pthomas/ttsky-sigma-delta/STATUS.md

# Project status & session handoff

DESIGN.md is the append-only **decision log** (restructured 2026-07-26:
goals live in README.md, architecture/method/measured specs in docs/ —
the CI-generated manual — and toolchain + drive instructions here); this
file holds *where things stand and how to drive them*. Update both at the
end of significant work sessions.

**Trust note:** two magic gotchas have burned this project's DRC numbers in
both directions (see DESIGN.md 2026-07-19 decision log entries): (1) fresh
`load` without `select top cell; expand` silently skips hierarchy-crossing
checks (false clean); (2) `writeall force` after `load` rewrites unmodified
gencell subcells with halved coordinates, manufacturing hundreds of fake
sub-0.005um violations on the *next* load (false dirty — the entire "894
remaining" saga was this artifact). The only trustworthy number is a fresh
process on the saved files with expand; route_ota.py now prints exactly
that ("DRC errors (fresh reload of saved files)").

## Snapshot 2026-07-26 (current — read this first)

**The chip is submission-ready and materially better than the 07-25
morning version.** Full story in DESIGN.md (all dated 07-25/07-26);
one-paragraph version: the 0–3.3 V input range landed (RIN 132k +
ROFF 158.4k offset leg, thin-poly); the extracted-vs-tier-1 SNDR gap
was decomposed by a netlist-ladder A/B and turned out to be (a) slow
clk33 rise — fixed by lvl W_BP=20 + mid-row buffers — and (b) a
half-cycle excess loop delay from the StrongARM sensing on its
clock's FALL — fixed by clocking the comparator on clkb33 and driving
the DAC switches from its SR latch (DFF now retimes outputs only).
Extracted fast-path SNDR: **38.3–40.7 dB** (above the tier-1 band
36.4–38.0), corners ss 33.4 / ff 35.3. Acceptance re-instrumented:
2048-bit window, gate 36 (512-bit windows scatter ±3 dB). Analog
pins: **back to 2 (VIN + INT)** — the 07-26-morning VOFF +
vcm/vrefp-monitor pins were removed the same day on cost
(100 €/pin after the first two; 380 → 80 €); references are
validated through transfer-function inference instead (docs/09b
Phase 1), and the commercial window-slide experiment moves to v2.
Rebuilt + re-verified: sd_top DRC 0 / LVS match, extracted 40.2 dB,
frame DRC 0.

| Area | State |
|---|---|
| Nightly CI | scheduled 03:00 MT (GitLab schedule 4359193): assembly-verify (full from-source top regression) + top-corners. top-corners first regenerates the PEX and diffs it against the committed golden `spice/sd_top_pex.spice` (see DESIGN.md 2026-08-01) — a diff there means the deck drifted (layout/magic/PDK): review it, rerun the corner suite, update gates (measured − 2 dB to nearest 0.5), recommit the netlist. Never retry. Gates: ss 32 / ff 36.5 / v3.0 36 / v3.6 32.5 / 0C 33 / 85C 35. |
| Site | 14 chapters incl. datasheet (CI-injected electrical tables) and silicon test plan (docs/09b, 4 phases, measured-vs-CI correlation table is the deliverable) |
| Commercial | **local-only branch `commercial`** (never push; no upstream set). COMMERCIAL.md: thesis, cost model, decisions (power-conversion socket, differential required → v2 = fully-differential + 2nd-order in ONE architecture pass), open questions for Paul (channels, funding, license, name, PGA) |
| Fabric RTL | **suite green** (5/5, CI rtl-verify + locally via ~/.venv + iverilog): sdm_rx.v (AXI4-Lite + dual sinc³), cocotb TB incl. both mixed-signal tests (committed PEX bitstream → RTL → registers); pex_bits.txt refreshed from the 2-pin chip's 40.2 dB acceptance run. rtl/PLAN.md review still open |
| Bench plan | PolarFire SoC bench board (TT demo board hosts the chip; header adapter TBD); DAC = AD5541A (kernel ad5446 driver; MikroE DAC 8 Click or Pmod DA3 module, or bare on the adapter) |
| Open (user-side) | **re-submit/update the TT shuttle entry (frame fix 2026-07-26: 22 floating outputs now tied — submitted GDS predates it)**; Pages visibility toggle; rtl/PLAN.md review |

**Next actions (fresh context starts here):** (1) Paul reviews
rtl/PLAN.md → iterate; (2) install sim tools → first cocotb run of
rtl/tb (expect small RTL/TB fixes — never run yet); (3) module 2
sdm_cap (raw-bit capture, needed for Phase-2 silicon SNDR); (4)
commercial-branch paper items (k-tolerance sweep has existing tier-1
machinery). Reminder: `git push` on main pushes BOTH remotes; the
commercial branch must never gain an upstream.

## Where we are

**Shuttle: TTSKY26c (sky130A), deadline 2026-09-07.** Repo pushed to
git@gitlab.com:pthomas1/sigma-delta.git. Shuttle entry:
https://app.tinytapeout.com/projects/5413 (integration PR:
TinyTapeout/tinytapeout-sky-26c#143).

| Area | State |
|---|---|
| Tier 0 (python model) | done — sim/tier0.py; pattern-noise statistics understood |
| Tier 1 (behavioral xschem/ngspice) | done — full modulator with realistic OTA model (AOL/GBW/SR), RZ totem-pole DAC, interactive scope workflow |
| NRZ-vs-RZ decision | done — RZ confirmed by data (reports/dac_compare.html) |
| Block spec table | done — measured knees in DESIGN.md (AOL≥300, GBW≥50M, SR≥100V/µs) |
| Tier 2 OTA schematic | done — folded cascode sized & corner-flat (A0 65dB, GBW 209MHz, PM 58°, ±195V/µs, 4.5mW); xschem/ota.sch GENERATED from sim/ota_tb.py SIZES; equivalence proven (make xcheck) |
| Tier 2 other blocks | **StrongARM comparator DONE** (PMOS input; inverter-buffered NAND SR latch after a real hysteresis bug — see DESIGN.md; tau 77 ps tt / 63–97 ps corners, worst decision 1.18 ns, 71 µW, offset σ 13.6 mV MC N=19; schematic generated + equivalence proven via make compcheck). **DFF retimer DONE** (master-slave TG, verified in-chain behind the real comparator: clk-to-Q 0.37 ns, zero mid-cycle transitions). **Bias generator DONE** (sim/bias_tb.py: constant-gm + cascoded mirrors + startup-disable; OTA acceptance A0 65.4/GBW 194M/PM 57° with real bias, corners tighter than ideal — see DESIGN.md; open: sch gen + layout, poly R). **Reference buffers DONE** (sim/buf_tb.py: 3× 5T unity followers, Zout 754Ω vs ≤1k spec = 10× under breakage, bit-dep residuals ≤6.9mV, 3.2mW, corners flat — see DESIGN.md; open: sch gen, bias tap, layout+decap). **Clock level shifter DONE** (sim/lvl_tb.py: cross-coupled 1.8→3.3V, full swing, <1ns, duty ≤2.42% vs 3% gate — static duty = benign gain shift; ~300µW; corners × VDPWR sweep). **Output drivers DONE** (sim/odrv_tb.py: 5V-gate stage on the 1.8V rail — no thin-oxide overstress — + thin-oxide buffers; full swing, ≤0.4ns, Q/QB skew ≤407ps, ~180µW; corners × VDPWR). Demux REJECTED, no differential, no true LVDS (see DESIGN.md IO decisions). **ALL BLOCKS DESIGNED — next: top-level assembly** |
| Tier 3 layout cells | done — mag/rin, rdac, cint, sw_nmos (extraction-verified values) |
| Tier 3 OTA layout | **DRC CLEAN + LVS CLEAN + PEX done** (fresh-process verified, fast & full DRC styles; make lvs: "Circuits match uniquely", 13/13 devices, 15/15 nets). Extracted (0.72 pF parasitics): A0 65.2 dB / GBW 119 MHz / PM 46° / SR +128/-508 V/µs / Ivdd 1.37 mA — all tier-1 knees (A0≥49.5 dB, GBW≥50 MHz, SR≥100 V/µs) still met ≥2×; PM 46° (was 58° pre-PEX) is the open question — see below |
| Tier 1 params | params.py: fs=50MHz, CINT=2pF; **refs at 0.4/0.9/1.4V (open item 6 done 2026-07-19)** — tier-1 39.1/66.6 dB at the new window; comp_beh output now pinned to the digital mid-rail (domain-split bug, see DESIGN.md) |
| CI | 4 sim jobs (smoke/reports) + new **layout-verify** job (xcheck → ota_tb → pex → layout_report; fails on DRC≠0 or LVS mismatch) + **pages** job publishing the generated design doc. Runner VM rebuilt with source-built magic/netgen — layout-verify green. New **comparator** job (comp_tb --quick + compcheck + dff_tb + figures) |
| Pages site | `make site` → public/index.html: 10-chapter narrative (docs/*.md) with CI-injected numbers via tools/gen_docs.py, interactive three.js 3D stack-up of the OTA GDS, verdict chips, GDS download. Set Pages visibility to "everyone" in GitLab project settings for the public showcase |

## OTA layout DRC — resolved (2026-07-19)

**DRC 0, LVS clean.** The "894 remaining" from the mid-cleanup snapshot
(and both of its root-cause hypotheses — strap `ty ± 1.5um` landing in the
finger structure, bulk-tap guard-ring geometry) turned out to be wrong: all
894 were fake, manufactured by magic's `writeall force` halving the
coordinates of unmodified gencell subcell files on save (grid-quantization
of odd 0.005um coordinates; full mechanism + proof in DESIGN.md 2026-07-19
entry). The violation slivers sat between *device-internal* shapes (poly
contact row vs S/D diffusion top), which no strap-height change could ever
have fixed. The met1/met2/met3 via-enclosure violations (~4140) were real
and remain fixed via the `ENCLOSING_LAYERS`/`PAD` auto-padding in
route_ota.py. route_ota.py now writes only the parent cell (`save
ota_layout`) and self-verifies DRC via a fresh magic process on the saved
files — expect "DRC errors (fresh reload of saved files): 0".

## OTA post-PEX numbers (2026-07-19)

`make pex` = tools/pex_ota.py (magic C-only extraction, cthresh 0, no R)
-> spice/ota_pex.spice, then sim/ota_tb.py --pex (same 3-DUT deck, layout
netlist wrapped to the 5-pin interface with ideal refs).

| Metric | Schematic | Extracted | Tier-1 knee | Verdict |
|---|---|---|---|---|
| A0 | 65.2 dB | 65.2 dB | ≥49.5 dB | ok |
| GBW | 209 MHz | 119 MHz | ≥50 MHz | ok (2.4×) |
| PM | 58° | 46° | no knee down to 28° | ok — **closed 2026-07-19** |
| SR | +197/−253 | +128/−508 | ≥100 V/µs | ok |
| Ivdd | 1.37 mA | 1.37 mA | — | 4.5 mW |

The GBW/PM hit is self-load from the auto-router's generous metal (0.50 µm
via pads, 0.8 µm-pitch m1 track bus, m3 risers): 0.72 pF total parasitic on
top of CL=1.5 pF. **Resolved 2026-07-19:** the FP2 sweep in `make specs`
measured no SNDR knee down to PM 28° (see DESIGN.md decision log) — 46°
extracted is accepted, OTA layout closed for v1. Note the tier-1 deck now
runs gear integration and the precision baseline reads 64.8 dB (the old
77.8 was a lucky deterministic window; long-run truth is ~66).

## Toolchain (dev machine)

- ngspice 42, xschem 3.4.4 (apt) — fine.
- magic **8.3.676 source-built** (`/usr/local/bin/magic`) — noble's 8.3.105 is
  too old for the PDK. Runner VM source-builds the same version (cloud-init).
- netgen **1.5.323 source-built** at /usr/local/bin (apt mesher removed).
- PDK: sky130A via ciel at `PDK_ROOT=/home/nvme/pdk` (pinned hash in
  ci/lxd/cloud-init.yml and DESIGN.md); `/opt/pdk` on the runner.
- glab installed but **no token stored** — `glab auth login` with api scope
  would enable pipeline debugging from the session.
- **magic batch DRC gotcha** (see DESIGN.md 2026-07-19 entry): always
  `select top cell; expand` before `drc check`/`drc listall ...` on anything
  loaded from a saved .mag file, or hierarchy-crossing violations are
  silently skipped and you'll see a false "0 errors".

## How to drive everything

From repo root (xschemrc auto-loads; PDK_ROOT defaults to /home/nvme/pdk):

- `make` / `make snr` — tier-1 sim + SNDR table (~10 s)
- `make framecheck` — TT requirements precheck misses: frame connectivity, tied outputs, info.yaml consistency, no met5 (after `make tt`)
- `make antenna` — magic antennacheck on sd_top (sky130A gets NO antenna check from TT precheck)
- `make jitter` — tier-0 clock-jitter susceptibility sweep (~30 s)
- `make noise` — OTA 1/f + thermal noise budget, `sim/noise_tb.py --pex` for extracted (~5 s)
- `make report` — NRZ/RZ comparison → reports/dac_compare.html (~70 s)
- `make char` — device curves → reports/fet_char.html (~15 s)
- `make specs` — OTA requirement sweeps → reports/ota_specs.html (~6 min)
- `python3 sim/ota_tb.py` — OTA testbench (edit SIZES dict to resize)
- `make xcheck` — regenerate xschem/ota.sch from SIZES + prove equivalence
- `make layout` — regenerate the four passive/switch cells in magic
- `make lvs` — netgen LVS, mag/ota_layout.spice vs spice/ota_top.spice
- `python3 tools/gen_ota_layout.py && python3 tools/route_ota.py` — regenerate
  + route the OTA layout, extraction-compare vs golden (expect 13/13); the
  trustworthy DRC number is the "fresh reload of saved files" line (expect 0)
- `make pex` — parasitic-extract the routed layout + run the OTA TB on it
- `make layout-report` — fresh-process DRC + LVS + GDS export + 3D geometry
  (fails if DRC ≠ 0 or LVS mismatch; feeds the site)
- `make site` — build public/ from docs/*.md + reports/results/*.json
  (preview: `cd public && python3 -m http.server`)
- GUI schematic: `xschem xschem/tier1_sdm.sch` → Netlist → Simulate (silent
  ~10 s) → Ctrl-click LOAD WAVES; f=fit, right-drag=zoom, a/b=cursors
- GUI layout: `magic -rcfile $PDK_ROOT/sky130A/libs.tech/magic/sky130A.magicrc mag/ota_layout.mag`

## Next actions — ASSEMBLY CAMPAIGN (all blocks -> layout -> TT frame)

User directive (2026-07-19): "do all the things" — lay out every block,
assemble the top level into the TT frame, per-component report sub-pages,
report when TT-ready. Commit per milestone. Ordered plan with the key
context a fresh session needs:

1. **Reference plan fix — DONE 2026-07-19.** CDEC = 5 pF per reference
   (tier-1 validated at RREF=754, CDEC 20/10/5/2 pF all inside scatter;
   ~7.5k um^2 total MiM, fits). Ladder added: 190k/50k/50k/40k off VAPWR
   (~10 uA) feeding the buffer gates, now in sim/buf_tb.py (ACCEPT:
   bit-dep <= 2.5 mV, DC <= 39 mV, 3.2 mW). TB isi metric fixed to
   sample the pulse-inherited state (period-end sampling false-failed
   small decaps). Full entry in DESIGN.md.
2. **Golden netlists + xschem schematics — DONE 2026-07-19.** `make
   blockcheck`: tools/gen_golden.py emits spice/golden/<b>.spice for all
   six blocks (bias with real poly-R/MiM cards, ngspice-model-calibrated
   lengths — see DESIGN.md; ACCEPT via `bias_tb.py --layout`);
   tools/gen_sch.py draws dff/bias/buf/lvl/odrv schematics+syms+wrappers;
   tools/xcheck_blocks.py proves device-for-device identity + port order
   (ALL MATCH). buf tail is now a real mirror off the OTA IREFP diode
   line (mult 64). RNB isolation Rs 100→1k (poly end-resistance floor).
   CI support-blocks job runs the layout variant + blockcheck.
3. **Block layouts — DONE 2026-07-19.** tools/lay_lib.py (golden-driven
   place/strap/route/DRC/LVS library) + tools/gen_block_layouts.py (row
   plans). ALL SIX CLEAN: DRC 0 fresh-process, devices matched, netgen
   LVS match — comp 67x22, dff 58x22, bias 86x113, buf 85x33, lvl
   38x26, odrv 9x55 um. Empirical router rules in DESIGN.md (thin-oxide
   L=0.35 mandatory, G-tap m1 flag, res via1-on-end-m1, same-net tap
   merging, go-wide floorplans, grid-snapped via centers). Bias/ladder
   R cells + MiM decaps for top level still to generate at assembly
   (cint/gen_layout_cells pattern).
4. **Top assembly -- DONE 2026-07-20.** sd_top: magic DRC
   fresh-process 0, netgen "Circuits match uniquely" (0 property
   errors), all 8 ports (UA0 UO0 UO1 CLK VDPWR UA1 VGND VAPWR).
   `python3 tools/asm_route.py && python3 tools/asm_top.py` rebuilds
   and re-verifies everything. tools/asm_route.py = geometry-precise
   maze router (real per-instance m3 + mimcap halos as obstacles,
   terminal/port-column/cap-bus ownership seeding, v-forced block-port
   entries, bounded exact-rides with validated jogs + collinear prune,
   3 hand patches); tools/asm_top.py = placement + terminal taps +
   painting + audit + DRC + LVS. Full mechanism narrative and the
   six-fix endgame in DESIGN.md 2026-07-20 entries -- READ THEM before
   touching the router. Caps moved: cdec2/cdec3 now at y=193, cdec3 at
   x=78 (corridor capacity); CLK pin at (75,218).
5. **Extracted acceptance -- DIAGNOSED 2026-07-20, awaiting accept
   decision.** Loop modulates on extracted silicon: 4096-bit matched
   window gives 34.7 dB fast-path SNDR (5.5 ENOB) vs tier-1's 39.1 and
   the 35 dB gate. Root cause characterized (DESIGN.md night entry):
   a FLAT unshaped noise floor from the decision path (comparator
   under real clock slew / DAC pulse ISI) -- the loop itself is
   healthy (no clipping, harmonics <= -45 dBc). Also fixed en route:
   the DFF polarity bug (commit 5f7bdc8). Recommendation: accept for
   v1 (0.3 dB under an aspirational floor, flow-proving mission),
   attack the decision path in v2. USER SIGNED OFF 2026-07-21 (both
   the 34.7 dB v1 accept and the 2x2/4-tile purchase). make pextop
   && make topaccept reproduces (sim/top_tb.py --bits/--sigbin).
6. **Report sub-pages -- DONE 2026-07-24.** tools/block_report.py
   (generalized geometry flattener, magscale-aware, full stack incl
   met4/MiM/poly-res) + gen_docs.py block_pages(): seven sub-pages at
   public/blocks/<b>.html (verdict chip + measured table + generated
   schematic SVG + own 3D view); main-page viewer shows the COMPLETE
   sd_top (64k rects) with links to the sub-pages. CI pages job runs
   block_report before gen_docs; `make blockreports` locally.
   Pipeline #41 green, site deployed -- but Pages is still
   members-only (redirects to sign-in): the standing user-side action
   is Settings > General > Visibility > Pages = Everyone.
7. **TT final -- READY 2026-07-21.** `make tt` builds the frame
   (tt_frame/build_frame.tcl: sd_top at origin in the 2x2 template,
   def-pin hookups by coordinate, three full-height power stripes with
   full-stripe port labels -- precheck requires port geometry within
   10um of both tile edges), frame DRC 0, GDS+LEF exported. info.yaml:
   2x2 tiles, pinout complete. Pushed (GitLab + GitHub mirror);
   GitHub Actions gds/precheck/viewer ALL GREEN on ttsky26c
   (run 29825237808). Remaining USER action: submit the GitHub repo
   on the Tiny Tapeout shuttle page before the 2026-09-07 deadline.
   Open (non-gating): report sub-pages (STATUS item 6), v2
   decision-path improvement (DESIGN.md 2026-07-20 night entry).
Standing context: user handles repo creation/settings; Pages
unique-domain toggle still pending on user side (then add the clean URL
to README); CI locked to push-only pipelines; support-blocks CI job
gates bias/buf/lvl/odrv; DESIGN.md decision log is append-only and has
today's 15+ entries (magic gotchas, race-sim methodology, PM/RREF/SR
knees, IO decisions — READ IT before re-deriving anything).
## Open questions for the user

- ~~Source impedance (open item 7)~~ CLOSED 2026-07-25: the user's
  system context is ADS131A04-class inputs (~130 kohm switched-cap
  effective impedance), so our continuous 132 kohm resistive input is
  equal-or-easier to drive (no sampling kickback). Passive
  virtual-ground network confirmed sufficient.
- ~~2 vs 4 tiles~~ CLOSED 2026-07-21: 2x2 (4 tiles) signed off (the
  routed floorplan requires it). Original note: area budget said 2
  works for 1st
  order, buy 4 if 2nd order/differential is the ambition).
