pthomas/ttsky-sigma-delta/docs/04-tier1.md

# Tier 1: the modulator as a behavioral circuit

The tier-1 deck (`xschem/tier1_sdm.sch`) is the whole loop as a circuit —
active-RC integrator around a behavioral operational transconductance
amplifier (OTA), clocked comparator, retiming
DFF, and the RZ totem-pole DAC — with each block's non-idealities exposed
as parameters from `params.py`: OTA DC gain, GBW and slew rate, DAC pulse
shape and edge asymmetry, one full cycle of loop delay, comparator
decision quality.

This is the workhorse tier: fast enough to run in seconds, faithful enough
that every architecture decision (RZ vs NRZ, CINT resize, reference window)
was made by measuring SNDR here, not by argument.

This is the actual simulated schematic — behavioral blocks wired exactly
as the silicon will be:

{{fig_sch_tier1}}

{{fig_tier1_waves}}

The loop's story is easiest to follow one station at a time. The four
traces below are the four labeled nodes of the schematic above — `int`,
`comp`, `q`, `dac` — over the same twenty clock cycles: the integrator
drifts, the comparator decides (note it committing at *different times*
within each cycle), the retimed bit releases each decision only on the
clock edge, and the return-to-zero DAC pulse carries it back to the
input summing node. The behavioral models behind each block (finite
gain/bandwidth/slew for the amplifier, regeneration softness for the
comparator) are plain ngspice subcircuits embedded in the schematic
source, with their parameters injected from `params.py`.

{{fig_tier1_loop_trip}}

The spectrum below is the whole thesis of the architecture in one picture:
the signal sits in a quiet band at the left while the quantization noise —
which had to go *somewhere* — has been pushed up and out, rising at the
first-order loop's +20 dB/decade:

{{fig_tier1_spectrum}}

The bitstream analysis (`sim/snr.py`) resamples the comparator output at
mid-period, takes a coherent fast Fourier transform (FFT), and integrates
noise + distortion to
each path's band edge:

{{snr_table}}

The CI pipeline runs this on every push and asserts a loose floor on the
fast path (per the pattern-noise scatter discussed in the architecture
chapter — a first-order modulator's windowed SNDR is chaotic at the
±1–2 dB level, so exact-value assertions would be flaky by construction).

Supporting reports generated by the pipeline:

{{report_links}}
