pthomas/ttsky-sigma-delta/reports/ota_specs.html

# OTA requirements sweep — tier-1 modulator

One parameter varied at a time; baseline AOL = 10000, GBW = 200 MHz, SR = 200 V/μs, FP2 = none (gray verticals). The FP2 sweep adds a buffered second pole to the OTA model; each point is labeled with the equivalent OTA unity-gain phase margin, so the extracted layout's PM can be judged against a measured knee instead of a rule of thumb. fs = 50 MHz, 16384 bits, pinned dither seed. Precision-path values scatter ~±1 dB run to run (pattern noise) — read knees, not digits.

param | value | SNDR @ 1 MHz | SNDR @ 100 kHz
AOL | 30 V/V | 26.1 dB | 38.1 dB
AOL | 100 V/V | 37.5 dB | 52.9 dB
AOL | 300 V/V | 38.9 dB | 57.2 dB
AOL | 1e+03 V/V | 39.4 dB | 63.2 dB
AOL | 3e+03 V/V | 38.1 dB | 56.5 dB
AOL | 1e+04 V/V | 38.7 dB | 55.5 dB
GBW | 25 MHz | 37.6 dB | 62.2 dB
GBW | 50 MHz | 38.3 dB | 55.0 dB
GBW | 100 MHz | 39.5 dB | 60.1 dB
GBW | 150 MHz | 39.9 dB | 60.9 dB
GBW | 200 MHz | 38.8 dB | 54.5 dB
GBW | 400 MHz | 38.4 dB | 56.8 dB
SR | 12.5 V/us | 39.3 dB | 54.8 dB
SR | 25 V/us | 39.5 dB | 63.9 dB
SR | 50 V/us | 39.1 dB | 60.9 dB
SR | 100 V/us | 39.5 dB | 62.7 dB
SR | 200 V/us | 38.7 dB | 56.4 dB
SR | 400 V/us | 37.5 dB | 55.7 dB
FP2 | 50 MHz (PM 28°) | 39.1 dB | 63.8 dB
FP2 | 100 MHz (PM 39°) | 38.7 dB | 56.4 dB
FP2 | 141 MHz (PM 45°) | 39.1 dB | 62.0 dB
FP2 | 200 MHz (PM 52°) | 39.6 dB | 62.4 dB
FP2 | 400 MHz (PM 66°) | 38.7 dB | 56.3 dB
FP2 | 800 MHz (PM 76°) | 37.9 dB | 53.6 dB
FP2 | 2e+03 MHz (PM 84°) | 37.7 dB | 53.7 dB
