pthomas/ttsky-sigma-delta/reports/fet_char.html

# sky130 3.3 V FET characterization (tt corner)

Devices: sky130_fd_pr__nfet/pfet_g5v0d10v5, W = 10.0 um. Constant-current Vth (Id = 1μA·W/L, L = 0.5): nfet 0.86 V, pfet 1.10 V.

## gm/Id vs current density (OTA sizing curves)

Weak inversion plateau left, strong inversion right. Pick a gm/Id, read the current density, get W from the target current.

## Pass-switch ron vs passed voltage (reference-window decision)

NMOS with 3.3 V gate, PMOS with 0 V gate, both W = 10.0/0.5 um; dashed = parallel t-gate. Vertical markers: proposed low window (0.4/0.9/1.4 V) and the old 3.3 V-centered VREFP at 2.15 V.

passed voltage | NMOS ron (W=10um) | ron·W
0.40 V | 229 Ω | 2 Ω·um
0.90 V | 290 Ω | 3 Ω·um
1.40 V | 441 Ω | 4 Ω·um
1.65 V | 648 Ω | 6 Ω·um
2.15 V | 35,495 Ω | 355 Ω·um
