pthomas/ttsky-sigma-delta/reports/dac_compare.html

# NRZ vs RZ feedback DAC — tier-1 CT ΣΔ modulator

1st order, 1-bit, fs = 50 MHz, input 0.3 V (-4.4 dBFS) at 27.5 kHz, 16384 bits per run. Feedback charge per period is equalized (NRZ uses 2×RDAC). "Asymmetric" raises the pull-down switch resistance 100 → 2000 Ω against a 100 fF DAC-node capacitance — about 190 ps of rise/fall asymmetry, the ISI mechanism.

variant | SNDR @ 1 MHz | ENOB | SNDR @ 100 kHz | ENOB
RZ, symmetric | 38.1 dB | 6.0 | 62.4 dB | 10.1
RZ, asymmetric | 39.1 dB | 6.2 | 56.9 dB | 9.2
NRZ, symmetric | 38.0 dB | 6.0 | 56.9 dB | 9.2
NRZ, asymmetric | 38.8 dB | 6.1 | 48.3 dB | 7.7

Caveat on absolute numbers: 1st-order in-band noise is dominated by pattern tones; at a 16k window the ideal tier-0 model scatters 53.6–66.8 dB across dither seeds (long-run converges to ~66 dB, ~10 ENOB). All four variants here share one fixed noise seed (rndseed=17), so the RZ/NRZ and sym/asym differences are paired and meaningful even though each absolute value carries the window-luck spread.

## Output spectrum

Coherent FFT of the bitstream; faint traces are raw bins, solid lines a 15-bin moving average. Left: ideal switches — RZ and NRZ overlap. Right: asymmetric switches — NRZ grows harmonics and a raised floor (signal-dependent transition errors), RZ is unchanged (every pulse carries the same edge pair, so the error is a fixed gain term).

## DAC node waveforms (asymmetric case)

RZ returns to VCM = 1.65 V every clock-high half-period; NRZ holds the selected reference for full periods and only moves on bit transitions.
