pthomas/ttsky-sigma-delta/docs/09b-testplan.md

# Silicon test plan

The bring-up and validation plan for the TTSKY26c silicon. Its
organizing principle mirrors the repo's: **every measurement has a
CI-generated prediction to correlate against**, and the deliverable
of each test is a measured-vs-predicted row, not just a number. The
correlation table is the credibility artifact for everything this
design methodology claims.

## Equipment

- TinyTapeout demo board (RP2040) hosts the chip throughout: power,
  project selection via the ttboard MicroPython SDK, and the Phase-0
  first-light tests. For capture and precision work, a to-be-designed
  interface adapts the demo board's pin headers to the PolarFire SoC
  bench board: clock from the FPGA to the clk header, Q/Q̄ from the
  uo headers into LVCMOS inputs, and analog access at the ua headers
  (design TBD — algofoogle/tt06-grab-bag's adapter PCB on demo-board
  headers, KiCad + Gerbers in-repo, is a useful precedent). The
  demo-board passives risk below applies doubly here: every header
  pin used must be checked against the demo board schematic for
  populated pulls/dividers.
- Clean 50 MHz clock source (FPGA PLL output is fine; avoid RC
  oscillators — RZ feedback doubles jitter sensitivity). **Know your
  source's jitter before judging SNDR**: the measured susceptibility
  curve (`make jitter`, reports/results/jitter.json) puts the knees at
  ~24 ps RMS per edge (precision path) and ~170 ps (fast path), with
  20 dB/decade degradation above. An RP2040 GPIO clock (first light)
  or a spread-spectrum source can sit above the precision knee — a
  "bad" precision SNDR on such a clock is *predicted*, not a dead
  chip. Fast-path SNDR is the robust first-light metric.
- Signal source: **AD5541A** (kernel `ad5446` driver; MikroE DAC 8
  Click or Pmod DA3 module on the bench board) for all DC work —
  **referenced to the same cleaned 3.3 V rail that feeds VAPWR**,
  not the breakout's onboard 2.5 V ref (lift/bypass it, or put a
  bare AD5541A on the carrier). Rail-as-reference makes the bench
  ratiometric end-to-end: DAC code → ADC reading is a pure ratio,
  independent of rail drift, and full scale covers the whole 0–3.3 V
  window. For AC SNDR tones: audio-grade DAC or generator,
  ≤−60 dBc THD preferred (the measurement floor should be the chip,
  not the source); SPI-rate updates cap clean AD5541A tones to
  roughly the precision band.
- DMM (6.5-digit preferred) for the DC tests;
  oscilloscope ≥200 MHz for output-eye and clock checks.
- Bench supplies: 3.3 V (VAPWR) and 1.8 V (VDPWR), current-limited.

**ESD handling.** The TT pads carry ESD cells, but treat the board as
CMOS-sensitive anyway — a marginal ESD hit degrades rather than kills,
and a shifted-but-alive chip poisons every correlation row. Rules:
wrist strap (or touch board ground first) whenever handling the demo
board or carrier; store spare boards in conductive foam, not loose;
discharge cables by touching their shield/signal to board ground
before plugging into any `ua` pin; assemble and solder the carrier
unpowered, iron grounded. Driving VIN from a powered source while the
chip is unpowered is safe by design (132 kΩ series limits clamp
current to ~25 µA — verified in the cold-start sims), but don't extend
that courtesy to the monitor-free 5 pF-class digital pins.

## Phase 0 — first light (minutes, RP2040 board is enough)

| # | Test | Procedure | Pass = |
|---|---|---|---|
| 0.0 | Board self-test | Before enabling our project: `tt.shuttle.tt_um_chip_rom.enable()`, read the ROM pattern via the ttboard MicroPython SDK | ROM reads back correctly — proves board, mux, and firmware before any measurement can implicate our die (bring-up pattern stolen from htfab/tt07-fprn) |
| 0.1 | Power | Apply 1.8/3.3 V, no clock | VAPWR current ~3 mA class, VDPWR <1 mA, nothing hot |
| 0.2 | Alive | 50 MHz clock, VIN grounded | Q/Q̄ toggling, complementary, ones density well below 0.5 |
| 0.3 | Rails respond | VIN to 3.3 V, then to VGND | ones density near 1, then near 0; recovery immediate |
| 0.4 | Mid-scale | VIN = 1.65 V (divider from VAPWR) | ones density 0.50 ± 0.03 (CI predicts 0.486–0.495) |

## Phase 1 — DC operating point (DMM, no capture needed)

| # | Test | Pins | Predicted (CI, tt corner) | Notes |
|---|---|---|---|---|
| 1.1 | Integrator DC | ua[1] | ~0.9 V mean (= vcm through the OTA's virtual short), activity visible | high-Z probe; this is also the only direct vcm observation — no monitor pins in v1 |
| 1.2 | Mid-scale null | find VIN where ones = 0.5 | 1.65 V ± gain error (thin-poly width bias predicts a few %) | infers vcm·(1+RIN/ROFF)−… : the input-network DC point, measured through the transfer function |
| 1.3 | Full scale | VIN at ones = 0.02 and 0.98 | span predicts (vrefp−vcm)·RIN/RDAC = ±1.65 V ratiometric | infers the vrefp−vcm reference span through known resistor ratios |
| 1.4 | Ratiometry | sweep VAPWR 3.0–3.6 V, repeat 1.2 | null tracks VAPWR/2 to <1% | the no-bandgap design claim, measured via the null instead of a monitor pin |

## Phase 2 — bitstream capture and SNDR (FPGA)

Capture setup: clock the chip from the FPGA; latch Q (and Q̄) on the
same clock's opposite edge or a phase-shifted copy (source-synchronous;
scan the phase until the eye is clean — this doubles as test 2.1).
Store ≥2²⁰ bits per run to allow many analysis windows.

| # | Test | Procedure | Predicted (extracted, tt) |
|---|---|---|---|
| 2.1 | Capture eye | phase-scan the capture clock | ≥120° of clean eye at 50 MHz |
| 2.2 | Fast-path SNDR | −4.4 dBFS tone ≈317 kHz, 2048-bit coherent windows (bin 13 at 50 MHz), sinc/FFT per `sim/snr.py` | 38–41 dB (measured 38.3–40.7 across windows); window scatter ±1.5 dB is EXPECTED — report the ensemble, not one window |
| 2.3 | Precision-path SNDR | same capture, OSR 250, 4096-bit windows | tier-1 band 54–67 dB (pattern-noise scatter documented); silicon adds thermal noise — expect the band's lower half |
| 2.4 | Ones-density linearity | DC sweep VIN 0→3.3 V in 0.1 V steps | straight line, slope = 1/3.3 per volt ± gain error from 1.2; INL from residuals |
| 2.5 | Clock sensitivity | repeat 2.2 at 25 and 60 MHz | loop scales with clock (ratiometric k); SNDR within ~2 dB of 50 MHz value |
| 2.6 | Jitter sensitivity | repeat 2.2 with a deliberately dirty clock (ring-osc or spread-spectrum) | degradation consistent with RZ 2× jitter model — a *characterization* row, no gate |

## Phase 3 — the correlation table (the point of the exercise)

Assemble every Phase 1–2 row into measured-vs-CI-predicted with:
prediction source (tier-1 / extracted / corner), measured value,
deviation, and verdict. Corner inference: if the DC points (1.1–1.4)
and SNDR sit consistently high or low, compare against the nightly
ss/ff corner runs (ss 33.4 dB, ff 35.3 dB extracted) to estimate
which corner the die drew. Publish the table as a site chapter —
it becomes the "silicon correlated" stamp on the datasheet and the
first hard evidence for the commercial-exploration thesis.

## Phase 4 — stretch / debug (only if something disagrees)

- ua[1] (integrator) waveform vs the extracted transient — shape,
  swing, and startup match.
- Reference droop: repeat 1.2/1.3 while sweeping bitstream activity
  (input near the rails vs mid-scale); a null/span shift beyond the
  predicted <0.1% points at the buffers (Zout ~750 Ω × decap corner).
- Duty-cycle stress: feed asymmetric clock (45/55), verify pure gain
  error (predicted ≤ ~7% gain shift at the 3.5% duty gate limit,
  zero SNDR penalty) — the RZ edge-immunity claim, measured.

## Risks / known unknowns

- References have no direct pins in v1 (cost: 100 €/analog pin after
  the first two); vcm and the vrefp−vcm span are validated through
  the transfer function (1.1–1.4). A dead loop leaves only ua[1] and
  supply currents as analog observables.
- The TT mux and board add series resistance and leakage to analog
  pins; measure the mux path resistance on an unused analog pin
  first and correct 1.2/1.3.
- **Demo board passives**: at least one TT08 analog project measured
  a degraded output amplitude because a demo-board pull-down resistor
  was still populated on the pin. Before interpreting any amplitude,
  check the demo board schematic for pulls/dividers on `uo[0]`,
  `uo[1]` and the `ua` pins in use.
- For the precision-path noise rows, power the board from a battery
  or linear supply — and still expect the odd unexplained low-kHz
  spur (a TT08 LDO project measured a clean battery-fed spectrum
  with one stray 21.3 kHz line). Correlation target from CI:
  126 µV RMS input-referred (reports/results/noise_pex.json);
  the same project measured silicon 1/f slightly BELOW the sky130
  simulation, so treat the CI number as an upper estimate.
- Thermal drift is uncharacterized (all sims 27 °C): note ambient
  for every row; a hot-air rework station sweep (25–85 °C) is the
  cheap version of a temperature characterization.
- Provision footprints for input filter caps (~10 pF C0G to ground
  at VIN, plus an RC slot) on the header adapter: the tt06 SAR
  silicon showed interference-shaped harmonics on the analog input
  that input caps historically fixed. Cheap insurance, DNP by
  default (VIN already sees 132 kΩ, so even 100 pF only makes a
  12 kHz pole — fine for DC rows, remove for AC SNDR rows).
- Expect silicon timing toward the slow corner: the tt06 SAR
  measured its clk-to-done path at ~2× the typical-corner sim. Our
  speed paths carry 8× margin (comparator worst decision 1.18 ns vs
  the 10 ns half-period) and the nightly ss corner is gated, but
  read any marginal timing observation against ss predictions, not
  tt.
