pthomas/ttsky-sigma-delta/spice/sd_top_pex.spice

* SPICE3 file created from sd_top.ext - technology: sky130A

.subckt sd_top UA0 UO0 UO1 CLK VDPWR UA1 VGND VAPWR
X0 buf_layout_2/IN VAPWR VGND sky130_fd_pr__res_high_po_1p41 l=824.88
X1 dff_layout_0/si dff_layout_0/CLK dff_layout_0/mb VGND sky130_fd_pr__nfet_g5v0d10v5 ad=1.45 pd=10.58 as=1.45 ps=10.58 w=5 l=0.5
X2 dff_layout_0/si dff_layout_0/clkb dff_layout_0/mb VAPWR sky130_fd_pr__pfet_g5v0d10v5 ad=1.45 pd=10.58 as=1.45 ps=10.58 w=5 l=0.5
X3 dff_layout_0/mi dff_layout_0/clkb dff_layout_0/D VGND sky130_fd_pr__nfet_g5v0d10v5 ad=2.9 pd=21.16 as=2.9 ps=21.16 w=5 l=0.5
X4 dff_layout_0/mi dff_layout_0/CLK dff_layout_0/D VAPWR sky130_fd_pr__pfet_g5v0d10v5 ad=2.9 pd=21.16 as=4.35 ps=31.74 w=5 l=0.5
X5 VGND dff_layout_0/QB dff_layout_0/sfb VGND sky130_fd_pr__nfet_g5v0d10v5 ad=149.35001 pd=1.08974k as=2.9 ps=21.16 w=5 l=0.5
X6 VGND dff_layout_0/si dff_layout_0/QB VGND sky130_fd_pr__nfet_g5v0d10v5 ad=0 pd=0 as=1.45 ps=10.58 w=5 l=0.5
X7 VAPWR dff_layout_0/QB dff_layout_0/sfb VAPWR sky130_fd_pr__pfet_g5v0d10v5 ad=326.25 pd=2.3805k as=2.9 ps=21.16 w=5 l=0.5
X8 VAPWR dff_layout_0/si dff_layout_0/QB VAPWR sky130_fd_pr__pfet_g5v0d10v5 ad=0 pd=0 as=1.45 ps=10.58 w=5 l=0.5
X9 VGND dff_layout_0/QB dff_layout_0/Q VGND sky130_fd_pr__nfet_g5v0d10v5 ad=0 pd=0 as=1.45 ps=10.58 w=5 l=0.5
X10 VGND dff_layout_0/CLK dff_layout_0/clkb VGND sky130_fd_pr__nfet_g5v0d10v5 ad=0 pd=0 as=1.45 ps=10.58 w=5 l=0.5
X11 VAPWR dff_layout_0/QB dff_layout_0/Q VAPWR sky130_fd_pr__pfet_g5v0d10v5 ad=0 pd=0 as=1.45 ps=10.58 w=5 l=0.5
X12 VAPWR dff_layout_0/CLK dff_layout_0/clkb VAPWR sky130_fd_pr__pfet_g5v0d10v5 ad=0 pd=0 as=1.45 ps=10.58 w=5 l=0.5
X13 dff_layout_0/si dff_layout_0/clkb dff_layout_0/sfb VGND sky130_fd_pr__nfet_g5v0d10v5 ad=2.9 pd=21.16 as=0 ps=0 w=5 l=0.5
X14 dff_layout_0/si dff_layout_0/CLK dff_layout_0/sfb VAPWR sky130_fd_pr__pfet_g5v0d10v5 ad=2.9 pd=21.16 as=0 ps=0 w=5 l=0.5
X15 VGND dff_layout_0/mb dff_layout_0/mfb VGND sky130_fd_pr__nfet_g5v0d10v5 ad=0 pd=0 as=2.9 ps=21.16 w=5 l=0.5
X16 VGND dff_layout_0/mi dff_layout_0/mb VGND sky130_fd_pr__nfet_g5v0d10v5 ad=0 pd=0 as=2.9 ps=21.16 w=5 l=0.5
X17 VAPWR dff_layout_0/mb dff_layout_0/mfb VAPWR sky130_fd_pr__pfet_g5v0d10v5 ad=0 pd=0 as=2.9 ps=21.16 w=5 l=0.5
X18 VAPWR dff_layout_0/mi dff_layout_0/mb VAPWR sky130_fd_pr__pfet_g5v0d10v5 ad=0 pd=0 as=2.9 ps=21.16 w=5 l=0.5
X19 dff_layout_0/mi dff_layout_0/CLK dff_layout_0/mfb VGND sky130_fd_pr__nfet_g5v0d10v5 ad=0 pd=0 as=0 ps=0 w=5 l=0.5
X20 dff_layout_0/mi dff_layout_0/clkb dff_layout_0/mfb VAPWR sky130_fd_pr__pfet_g5v0d10v5 ad=0 pd=0 as=0 ps=0 w=5 l=0.5
X21 VAPWR comp_layout_0/n1b dff_layout_0/D VAPWR sky130_fd_pr__pfet_g5v0d10v5 ad=0 pd=0 as=0 ps=0 w=5 l=0.5
X22 comp_layout_0/di1 UA1 comp_layout_0/tail VAPWR sky130_fd_pr__pfet_g5v0d10v5 ad=1.45 pd=10.58 as=0.725 ps=5.29 w=5 l=0.5 M=2
X23 VAPWR comp_layout_0/Q dff_layout_0/D VAPWR sky130_fd_pr__pfet_g5v0d10v5 ad=0 pd=0 as=0 ps=0 w=5 l=0.5
X24 comp_layout_0/di1 comp_layout_0/on2 comp_layout_0/on1 VAPWR sky130_fd_pr__pfet_g5v0d10v5 ad=4.35 pd=31.74 as=1.45 ps=10.58 w=5 l=0.5
X25 comp_layout_0/di2 ota_layout_0/INP comp_layout_0/tail VAPWR sky130_fd_pr__pfet_g5v0d10v5 ad=4.35 pd=31.74 as=5.8 ps=42.32 w=5 l=0.5 M=2
X26 comp_layout_0/di2 comp_layout_0/on1 comp_layout_0/on2 VAPWR sky130_fd_pr__pfet_g5v0d10v5 ad=0 pd=0 as=1.45 ps=10.58 w=5 l=0.5
X27 comp_layout_0/sb comp_layout_0/n1b dff_layout_0/D VGND sky130_fd_pr__nfet_g5v0d10v5 ad=2.9 pd=21.16 as=0 ps=0 w=5 l=0.5
X28 VGND comp_layout_0/Q comp_layout_0/sb VGND sky130_fd_pr__nfet_g5v0d10v5 ad=0 pd=0 as=0 ps=0 w=5 l=0.5
X29 VGND comp_layout_0/on2 comp_layout_0/on1 VGND sky130_fd_pr__nfet_g5v0d10v5 ad=0 pd=0 as=2.9 ps=21.16 w=5 l=0.5
X30 VGND comp_layout_0/on1 comp_layout_0/on2 VGND sky130_fd_pr__nfet_g5v0d10v5 ad=0 pd=0 as=2.9 ps=21.16 w=5 l=0.5
X31 VAPWR comp_layout_0/n2b comp_layout_0/Q VAPWR sky130_fd_pr__pfet_g5v0d10v5 ad=0 pd=0 as=2.9 ps=21.16 w=5 l=0.5
X32 VAPWR dff_layout_0/D comp_layout_0/Q VAPWR sky130_fd_pr__pfet_g5v0d10v5 ad=0 pd=0 as=0 ps=0 w=5 l=0.5
X33 VGND dff_layout_0/D comp_layout_0/sq VGND sky130_fd_pr__nfet_g5v0d10v5 ad=0 pd=0 as=2.9 ps=21.16 w=5 l=0.5
X34 comp_layout_0/sq comp_layout_0/n2b comp_layout_0/Q VGND sky130_fd_pr__nfet_g5v0d10v5 ad=0 pd=0 as=1.45 ps=10.58 w=5 l=0.5
X35 VGND comp_layout_0/CLK comp_layout_0/di1 VGND sky130_fd_pr__nfet_g5v0d10v5 ad=0 pd=0 as=1.45 ps=10.58 w=5 l=0.5
X36 VGND comp_layout_0/CLK comp_layout_0/di2 VGND sky130_fd_pr__nfet_g5v0d10v5 ad=0 pd=0 as=1.45 ps=10.58 w=5 l=0.5
X37 VGND comp_layout_0/CLK comp_layout_0/on1 VGND sky130_fd_pr__nfet_g5v0d10v5 ad=0 pd=0 as=0 ps=0 w=5 l=0.5
X38 VGND comp_layout_0/CLK comp_layout_0/on2 VGND sky130_fd_pr__nfet_g5v0d10v5 ad=0 pd=0 as=0 ps=0 w=5 l=0.5
X39 VGND comp_layout_0/on2 comp_layout_0/n2b VGND sky130_fd_pr__nfet_g5v0d10v5 ad=0 pd=0 as=1.45 ps=10.58 w=5 l=0.5
X40 VAPWR comp_layout_0/on2 comp_layout_0/n2b VAPWR sky130_fd_pr__pfet_g5v0d10v5 ad=0 pd=0 as=1.45 ps=10.58 w=5 l=0.5
X41 VGND comp_layout_0/on1 comp_layout_0/n1b VGND sky130_fd_pr__nfet_g5v0d10v5 ad=0 pd=0 as=1.45 ps=10.58 w=5 l=0.5
X42 VAPWR comp_layout_0/on1 comp_layout_0/n1b VAPWR sky130_fd_pr__pfet_g5v0d10v5 ad=0 pd=0 as=1.45 ps=10.58 w=5 l=0.5
X43 comp_layout_0/tail comp_layout_0/CLK VAPWR VAPWR sky130_fd_pr__pfet_g5v0d10v5 ad=0 pd=0 as=0 ps=0 w=5 l=0.5 M=2
X44 VAPWR ota_layout_0/dio ota_layout_0/pc2 VAPWR sky130_fd_pr__pfet_g5v0d10v5 ad=0.725 pd=5.29 as=1.45 ps=10.58 w=5 l=0.7 M=12
X45 ota_layout_0/tail ota_layout_0/IREFP VAPWR VAPWR sky130_fd_pr__pfet_g5v0d10v5 ad=0.725 pd=5.29 as=0.725 ps=5.29 w=5 l=1 M=76
X46 ota_layout_0/fn1 ota_layout_0/INP ota_layout_0/tail ota_layout_0/tail sky130_fd_pr__pfet_g5v0d10v5 ad=0.725 pd=5.29 as=0.725 ps=5.29 w=5 l=0.7 M=50
X47 ota_layout_0/fn2 ota_layout_0/INM ota_layout_0/tail ota_layout_0/tail sky130_fd_pr__pfet_g5v0d10v5 ad=37.7 pd=275.07999 as=129.05 ps=941.62 w=5 l=0.7 M=50
X48 VGND ota_layout_0/IREFN ota_layout_0/fn2 VGND sky130_fd_pr__nfet_g5v0d10v5 ad=0.725 pd=5.29 as=0.725 ps=5.29 w=5 l=1.2 M=24
X49 VGND ota_layout_0/IREFN ota_layout_0/fn1 VGND sky130_fd_pr__nfet_g5v0d10v5 ad=0 pd=0 as=36.25 ps=264.5 w=5 l=1.2 M=24
X50 ota_layout_0/dio ota_layout_0/VBNC ota_layout_0/fn1 VGND sky130_fd_pr__nfet_g5v0d10v5 ad=0.725 pd=5.29 as=0.725 ps=5.29 w=5 l=1 M=24
X51 UA1 ota_layout_0/VBNC ota_layout_0/fn2 VGND sky130_fd_pr__nfet_g5v0d10v5 ad=18.85 pd=137.53999 as=36.25 ps=264.5 w=5 l=1 M=24
X52 ota_layout_0/pc1 ota_layout_0/VBPC ota_layout_0/dio VAPWR sky130_fd_pr__pfet_g5v0d10v5 ad=18.85 pd=137.53999 as=10.15 ps=74.06 w=5 l=0.7 M=12
X53 VGND ota_layout_0/IREFN ota_layout_0/IREFN VGND sky130_fd_pr__nfet_g5v0d10v5 ad=0 pd=0 as=18.85 ps=137.53999 w=5 l=1.2 M=24
X54 ota_layout_0/IREFP ota_layout_0/IREFP VAPWR VAPWR sky130_fd_pr__pfet_g5v0d10v5 ad=56.55 pd=412.62 as=0 ps=0 w=5 l=1 M=76
X55 ota_layout_0/pc2 ota_layout_0/VBPC UA1 VAPWR sky130_fd_pr__pfet_g5v0d10v5 ad=18.85 pd=137.53999 as=10.15 ps=74.06 w=5 l=0.7 M=12
X56 VAPWR ota_layout_0/dio ota_layout_0/pc1 VAPWR sky130_fd_pr__pfet_g5v0d10v5 ad=0 pd=0 as=0 ps=0 w=5 l=0.7 M=12
X57 UA1 ota_layout_0/INM sky130_fd_pr__cap_mim_m3_1 l=20 w=25
X58 UA1 ota_layout_0/INM sky130_fd_pr__cap_mim_m3_1 l=20 w=25
X59 buf_layout_1/IN buf_layout_2/IN VGND sky130_fd_pr__res_high_po_1p41 l=216.23
X60 VGND buf_layout_0/IN VGND sky130_fd_pr__res_high_po_1p41 l=172.78
X61 ota_layout_0/VBNC VGND sky130_fd_pr__cap_mim_m3_1 l=22.2 w=22.2
X62 ota_layout_0/VBPC VGND sky130_fd_pr__cap_mim_m3_1 l=22.2 w=22.2
X63 buf_layout_0/IN buf_layout_1/IN VGND sky130_fd_pr__res_high_po_1p41 l=216.23
X64 ota_layout_0/INM UA0 VGND sky130_fd_pr__res_high_po_0p35 l=102.57
X65 buf_layout_0/tail buf_layout_0/IN buf_layout_0/o1 VAPWR sky130_fd_pr__pfet_g5v0d10v5 ad=0.725 pd=5.29 as=1.45 ps=10.58 w=5 l=0.5 M=12
X66 buf_layout_0/tail buf_layout_0/OUT buf_layout_0/OUT VAPWR sky130_fd_pr__pfet_g5v0d10v5 ad=66.7 pd=486.67999 as=10.15 ps=74.06 w=5 l=0.5 M=12
X67 buf_layout_0/o1 buf_layout_0/o1 VGND VGND sky130_fd_pr__nfet_g5v0d10v5 ad=1.45 pd=10.58 as=0.725 ps=5.29 w=5 l=1 M=6
X68 buf_layout_0/OUT buf_layout_0/o1 VGND VGND sky130_fd_pr__nfet_g5v0d10v5 ad=8.7 pd=62.9 as=0 ps=0 w=5 l=1 M=6
X69 buf_layout_0/tail ota_layout_0/IREFP VAPWR VAPWR sky130_fd_pr__pfet_g5v0d10v5 ad=0.725 pd=5.29 as=0.725 ps=5.29 w=5 l=1 M=64
X70 buf_layout_1/tail buf_layout_1/IN buf_layout_1/o1 VAPWR sky130_fd_pr__pfet_g5v0d10v5 ad=66.7 pd=486.67999 as=10.15 ps=74.06 w=5 l=0.5 M=12
X71 buf_layout_1/tail ota_layout_0/INP ota_layout_0/INP VAPWR sky130_fd_pr__pfet_g5v0d10v5 ad=0 pd=0 as=10.15 ps=74.06 w=5 l=0.5 M=12
X72 buf_layout_1/o1 buf_layout_1/o1 VGND VGND sky130_fd_pr__nfet_g5v0d10v5 ad=5.8 pd=42.32 as=0 ps=0 w=5 l=1 M=6
X73 ota_layout_0/INP buf_layout_1/o1 VGND VGND sky130_fd_pr__nfet_g5v0d10v5 ad=8.7 pd=62.9 as=0 ps=0 w=5 l=1 M=6
X74 buf_layout_1/tail ota_layout_0/IREFP VAPWR VAPWR sky130_fd_pr__pfet_g5v0d10v5 ad=0 pd=0 as=0 ps=0 w=5 l=1 M=64
X75 VGND ota_layout_0/INM VGND sky130_fd_pr__res_high_po_0p35 l=123.03
X76 buf_layout_2/tail buf_layout_2/IN buf_layout_2/o1 VAPWR sky130_fd_pr__pfet_g5v0d10v5 ad=66.7 pd=486.67999 as=10.15 ps=74.06 w=5 l=0.5 M=12
X77 buf_layout_2/tail buf_layout_2/OUT buf_layout_2/OUT VAPWR sky130_fd_pr__pfet_g5v0d10v5 ad=0 pd=0 as=10.15 ps=74.06 w=5 l=0.5 M=12
X78 buf_layout_2/o1 buf_layout_2/o1 VGND VGND sky130_fd_pr__nfet_g5v0d10v5 ad=5.8 pd=42.32 as=0 ps=0 w=5 l=1 M=6
X79 buf_layout_2/OUT buf_layout_2/o1 VGND VGND sky130_fd_pr__nfet_g5v0d10v5 ad=8.7 pd=62.9 as=0 ps=0 w=5 l=1 M=6
X80 buf_layout_2/tail ota_layout_0/IREFP VAPWR VAPWR sky130_fd_pr__pfet_g5v0d10v5 ad=0 pd=0 as=0 ps=0 w=5 l=1 M=64
X81 comp_layout_0/CLK lvl_layout_0/n2 VGND VGND sky130_fd_pr__nfet_g5v0d10v5 ad=1.45 pd=10.58 as=0.725 ps=5.29 w=5 l=0.5 M=2
X82 VAPWR lvl_layout_0/n2 comp_layout_0/CLK VAPWR sky130_fd_pr__pfet_g5v0d10v5 ad=0.725 pd=5.29 as=1.45 ps=10.58 w=5 l=0.5 M=4
X83 dff_layout_0/CLK lvl_layout_0/n1 VGND VGND sky130_fd_pr__nfet_g5v0d10v5 ad=2.9 pd=21.16 as=0 ps=0 w=5 l=0.5 M=2
X84 VAPWR lvl_layout_0/n1 dff_layout_0/CLK VAPWR sky130_fd_pr__pfet_g5v0d10v5 ad=0 pd=0 as=4.35 ps=31.74 w=5 l=0.5 M=4
X85 lvl_layout_0/n1 lvl_layout_0/n2 VAPWR VAPWR sky130_fd_pr__pfet_g5v0d10v5 ad=2.9 pd=21.16 as=0 ps=0 w=5 l=0.5 M=2
X86 VGND CLK lvl_layout_0/nb18 VGND sky130_fd_pr__nfet_01v8 ad=1.45 pd=10.58 as=1.45 ps=10.58 w=5 l=0.35
X87 lvl_layout_0/n2 lvl_layout_0/n1 VAPWR VAPWR sky130_fd_pr__pfet_g5v0d10v5 ad=2.9 pd=21.16 as=0 ps=0 w=5 l=0.5 M=2
X88 VGND CLK lvl_layout_0/n1 VGND sky130_fd_pr__nfet_g5v0d10v5 ad=0.725 pd=5.29 as=0.725 ps=5.29 w=5 l=0.5 M=8
X89 VDPWR CLK lvl_layout_0/nb18 VDPWR sky130_fd_pr__pfet_01v8 ad=2.9 pd=20.58 as=2.9 ps=20.58 w=10 l=0.35
X90 VGND lvl_layout_0/nb18 lvl_layout_0/n2 VGND sky130_fd_pr__nfet_g5v0d10v5 ad=0 pd=0 as=7.25 ps=52.9 w=5 l=0.5 M=8
X91 bias_layout_0/nb bias_layout_0/pb VAPWR VAPWR sky130_fd_pr__pfet_g5v0d10v5 ad=1.45 pd=10.58 as=0.725 ps=5.29 w=5 l=1 M=2
X92 bias_layout_0/pb bias_layout_0/pb VAPWR VAPWR sky130_fd_pr__pfet_g5v0d10v5 ad=2.9 pd=21.16 as=0 ps=0 w=5 l=1 M=2
X93 bias_layout_0/rs VGND VGND sky130_fd_pr__res_high_po_1p41 l=18.88
X94 VGND bias_layout_0/vbpc_i VGND sky130_fd_pr__res_high_po_1p41 l=105.03
X95 bias_layout_0/vbnc_i bias_layout_0/pb VAPWR VAPWR sky130_fd_pr__pfet_g5v0d10v5 ad=2.9 pd=21.16 as=0 ps=0 w=5 l=1 M=2
X96 VGND bias_layout_0/vbnc_i VGND sky130_fd_pr__res_high_po_1p41 l=314.01001
X97 bias_layout_0/vbpc_i bias_layout_0/pb VAPWR VAPWR sky130_fd_pr__pfet_g5v0d10v5 ad=2.9 pd=21.16 as=0 ps=0 w=5 l=1 M=2
X98 bias_layout_0/nst VGND bias_layout_0/nb VAPWR sky130_fd_pr__pfet_g5v0d10v5 ad=1.45 pd=10.58 as=1.45 ps=10.58 w=5 l=2
X99 VAPWR VGND bias_layout_0/nst VAPWR sky130_fd_pr__pfet_g5v0d10v5 ad=1.45 pd=10.58 as=1.45 ps=10.58 w=5 l=50
X100 ota_layout_0/IREFP bias_layout_0/vbnc_i bias_layout_0/ipd VGND sky130_fd_pr__nfet_g5v0d10v5 ad=0.725 pd=5.29 as=0.725 ps=5.29 w=5 l=0.5 M=38
X101 ota_layout_0/IREFN bias_layout_0/vbpc_i bias_layout_0/ind VAPWR sky130_fd_pr__pfet_g5v0d10v5 ad=0.725 pd=5.29 as=0.725 ps=5.29 w=5 l=0.5 M=34
X102 bias_layout_0/nst bias_layout_0/vbnc_i VGND VGND sky130_fd_pr__nfet_g5v0d10v5 ad=2.9 pd=21.16 as=0 ps=0 w=5 l=0.5 M=2
X103 bias_layout_0/vbpc_i ota_layout_0/VBPC VGND sky130_fd_pr__res_high_po_1p41 l=3.24
X104 bias_layout_0/vbnc_i ota_layout_0/VBNC VGND sky130_fd_pr__res_high_po_1p41 l=3.24
X105 VAPWR bias_layout_0/pb bias_layout_0/ind VAPWR sky130_fd_pr__pfet_g5v0d10v5 ad=0.725 pd=5.29 as=0.725 ps=5.29 w=5 l=1 M=34
X106 VGND bias_layout_0/nb bias_layout_0/ipd VGND sky130_fd_pr__nfet_g5v0d10v5 ad=0.725 pd=5.29 as=0.725 ps=5.29 w=5 l=1 M=38
X107 bias_layout_0/pb bias_layout_0/nb bias_layout_0/rs VGND sky130_fd_pr__nfet_g5v0d10v5 ad=1.45 pd=10.58 as=0.725 ps=5.29 w=5 l=1 M=8
X108 bias_layout_0/nb bias_layout_0/nb VGND VGND sky130_fd_pr__nfet_g5v0d10v5 ad=1.45 pd=10.58 as=0.725 ps=5.29 w=5 l=1 M=2
X109 VGND odrv_layout_0/b UO1 VGND sky130_fd_pr__nfet_01v8 ad=3.48 pd=24.58 as=3.48 ps=24.58 w=12 l=0.35
X110 VGND odrv_layout_0/a odrv_layout_0/b VGND sky130_fd_pr__nfet_01v8 ad=11.31 pd=80.9 as=1.45 ps=10.58 w=5 l=0.35
X111 VDPWR odrv_layout_0/b UO1 VDPWR sky130_fd_pr__pfet_01v8 ad=6.96 pd=48.58 as=6.96 ps=48.58 w=24 l=0.35
X112 VGND dff_layout_0/QB odrv_layout_0/a VGND sky130_fd_pr__nfet_g5v0d10v5 ad=0 pd=0 as=1.45 ps=10.58 w=5 l=0.5
X113 VDPWR odrv_layout_0/a odrv_layout_0/b VDPWR sky130_fd_pr__pfet_01v8 ad=22.62 pd=158.89999 as=2.9 ps=20.58 w=10 l=0.35
X114 odrv_layout_0/a dff_layout_0/QB VDPWR VDPWR sky130_fd_pr__pfet_g5v0d10v5 ad=2.9 pd=21.16 as=2.9 ps=21.16 w=5 l=0.5 M=2
X115 VGND odrv_layout_1/b UO0 VGND sky130_fd_pr__nfet_01v8 ad=0 pd=0 as=3.48 ps=24.58 w=12 l=0.35
X116 VGND odrv_layout_1/a odrv_layout_1/b VGND sky130_fd_pr__nfet_01v8 ad=0 pd=0 as=1.45 ps=10.58 w=5 l=0.35
X117 VDPWR odrv_layout_1/b UO0 VDPWR sky130_fd_pr__pfet_01v8 ad=0 pd=0 as=6.96 ps=48.58 w=24 l=0.35
X118 VGND dff_layout_0/Q odrv_layout_1/a VGND sky130_fd_pr__nfet_g5v0d10v5 ad=0 pd=0 as=1.45 ps=10.58 w=5 l=0.5
X119 VDPWR odrv_layout_1/a odrv_layout_1/b VDPWR sky130_fd_pr__pfet_01v8 ad=0 pd=0 as=2.9 ps=20.58 w=10 l=0.35
X120 odrv_layout_1/a dff_layout_0/Q VDPWR VDPWR sky130_fd_pr__pfet_g5v0d10v5 ad=2.9 pd=21.16 as=0 ps=0 w=5 l=0.5 M=2
X121 ota_layout_0/INP dff_layout_0/CLK rdac_0/X0/R1 VGND sky130_fd_pr__nfet_g5v0d10v5 ad=2.9 pd=20.58 as=2.9 ps=20.58 w=10 l=0.5
X122 sw_nmos_2/X0/D comp_layout_0/Q buf_layout_2/OUT VGND sky130_fd_pr__nfet_g5v0d10v5 ad=5.8 pd=41.16 as=0 ps=0 w=10 l=0.5
X123 ota_layout_0/INP VGND sky130_fd_pr__cap_mim_m3_1 l=20 w=25
X124 ota_layout_0/INP VGND sky130_fd_pr__cap_mim_m3_1 l=20 w=25
X125 rdac_0/X0/R1 comp_layout_0/CLK sw_nmos_2/X0/D VGND sky130_fd_pr__nfet_g5v0d10v5 ad=8.7 pd=61.74 as=0 ps=0 w=10 l=0.5
X126 ota_layout_0/INM rdac_0/X0/R1 VGND sky130_fd_pr__res_high_po_1p41 l=61.65
X127 buf_layout_0/OUT VGND sky130_fd_pr__cap_mim_m3_1 l=20 w=25
X128 buf_layout_0/OUT VGND sky130_fd_pr__cap_mim_m3_1 l=20 w=25
X129 sw_nmos_4/X0/D dff_layout_0/D buf_layout_0/OUT VGND sky130_fd_pr__nfet_g5v0d10v5 ad=5.8 pd=41.16 as=0 ps=0 w=10 l=0.5
X130 buf_layout_2/OUT VGND sky130_fd_pr__cap_mim_m3_1 l=20 w=25
X131 buf_layout_2/OUT VGND sky130_fd_pr__cap_mim_m3_1 l=20 w=25
X132 rdac_0/X0/R1 comp_layout_0/CLK sw_nmos_4/X0/D VGND sky130_fd_pr__nfet_g5v0d10v5 ad=0 pd=0 as=0 ps=0 w=10 l=0.5
C0 CLK UO0 0.14f
C1 CLK UO1 1.03f
C2 CLK VAPWR 1.386f
C3 CLK VDPWR 2.43f
C4 CLK VGND 16.59f
C5 CLK buf_layout_2/OUT 0.039f
C6 CLK comp_layout_0/CLK 0.532f
C7 CLK dff_layout_0/CLK 3.617f
C8 CLK dff_layout_0/D 0.267f
C9 CLK dff_layout_0/QB 0.014f
C10 CLK lvl_layout_0/n1 3.45f
C11 CLK lvl_layout_0/n2 0.424f
C12 CLK lvl_layout_0/nb18 0.771f
C13 CLK odrv_layout_0/a 0.001f
C14 CLK ota_layout_0/INP 0.577f
C15 UA0 UA1 0.228f
C16 UA0 VAPWR 0.175f
C17 UA0 VGND 11.811f
C18 UA0 bias_layout_0/ind 0
C19 UA0 bias_layout_0/ipd 0.001f
C20 UA0 bias_layout_0/nb 0.001f
C21 UA0 bias_layout_0/rs 0.014f
C22 UA0 bias_layout_0/vbnc_i 0.085f
C23 UA0 buf_layout_0/OUT 2.95f
C24 UA0 buf_layout_2/OUT 0.51f
C25 UA0 comp_layout_0/CLK 0.074f
C26 UA0 comp_layout_0/Q 0.029f
C27 UA0 dff_layout_0/CLK 0.029f
C28 UA0 dff_layout_0/D 0.044f
C29 UA0 ota_layout_0/INM 3.255f
C30 UA0 ota_layout_0/INP 0.352f
C31 UA0 ota_layout_0/IREFN 0.221f
C32 UA0 ota_layout_0/IREFP 0.413f
C33 UA0 ota_layout_0/VBNC 0.529f
C34 UA0 ota_layout_0/VBPC 0.13f
C35 UA0 rdac_0/X0/R1 0.793f
C36 UA0 sw_nmos_2/X0/D 0.286f
C37 UA0 sw_nmos_4/X0/D 0.3f
C38 UA1 VAPWR 5.284f
C39 UA1 VGND 21.817f
C40 UA1 buf_layout_0/OUT 1.562f
C41 UA1 buf_layout_2/OUT 0.653f
C42 UA1 comp_layout_0/CLK 5.164f
C43 UA1 comp_layout_0/Q 3.283f
C44 UA1 comp_layout_0/di1 1.4f
C45 UA1 comp_layout_0/di2 0.626f
C46 UA1 comp_layout_0/n1b 0.088f
C47 UA1 comp_layout_0/n2b 0.149f
C48 UA1 comp_layout_0/on1 0.221f
C49 UA1 comp_layout_0/on2 0.971f
C50 UA1 comp_layout_0/sb 0.028f
C51 UA1 comp_layout_0/sq 0.045f
C52 UA1 comp_layout_0/tail 0.995f
C53 UA1 dff_layout_0/CLK 0
C54 UA1 dff_layout_0/D 0.046f
C55 UA1 ota_layout_0/INM 93.731f
C56 UA1 ota_layout_0/INP 6.475f
C57 UA1 ota_layout_0/IREFN 6.313f
C58 UA1 ota_layout_0/IREFP 2.628f
C59 UA1 ota_layout_0/VBNC 12.199f
C60 UA1 ota_layout_0/VBPC 4.5f
C61 UA1 ota_layout_0/dio 0.38f
C62 UA1 ota_layout_0/fn1 2.874f
C63 UA1 ota_layout_0/fn2 10.145f
C64 UA1 ota_layout_0/pc1 0.002f
C65 UA1 ota_layout_0/pc2 10.221f
C66 UA1 ota_layout_0/tail 1.006f
C67 UA1 rdac_0/X0/R1 0.191f
C68 UO0 UO1 8.178f
C69 UO0 VAPWR 0.053f
C70 UO0 VDPWR 8.352f
C71 UO0 VGND 18.158f
C72 UO0 buf_layout_2/OUT 0
C73 UO0 dff_layout_0/D 0
C74 UO0 odrv_layout_1/a 0.021f
C75 UO0 odrv_layout_1/b 1.407f
C76 UO0 ota_layout_0/VBPC 0.15f
C77 UO1 VAPWR 1.456f
C78 UO1 VDPWR 8.791f
C79 UO1 VGND 11.147f
C80 UO1 buf_layout_2/OUT 0.009f
C81 UO1 dff_layout_0/D 0
C82 UO1 dff_layout_0/QB 0
C83 UO1 dff_layout_0/mi 0
C84 UO1 odrv_layout_0/a 0.02f
C85 UO1 odrv_layout_0/b 1.396f
C86 UO1 ota_layout_0/IREFP 0
C87 UO1 ota_layout_0/VBNC 0.048f
C88 UO1 ota_layout_0/VBPC 0.328f
C89 VAPWR VDPWR 0.386f
C90 VAPWR VGND 996.78f
C91 VAPWR bias_layout_0/ind 24.591f
C92 VAPWR bias_layout_0/ipd 1.072f
C93 VAPWR bias_layout_0/nb 4.752f
C94 VAPWR bias_layout_0/nst 2f
C95 VAPWR bias_layout_0/pb 43.699f
C96 VAPWR bias_layout_0/rs 0.916f
C97 VAPWR bias_layout_0/vbnc_i 3.869f
C98 VAPWR bias_layout_0/vbpc_i 13.115f
C99 VAPWR buf_layout_0/IN 5.796f
C100 VAPWR buf_layout_0/OUT 23.027f
C101 VAPWR buf_layout_0/o1 7.663f
C102 VAPWR buf_layout_0/tail 40.369f
C103 VAPWR buf_layout_1/IN 6.282f
C104 VAPWR buf_layout_1/o1 7.266f
C105 VAPWR buf_layout_1/tail 40.326f
C106 VAPWR buf_layout_2/IN 8.877f
C107 VAPWR buf_layout_2/OUT 25.638f
C108 VAPWR buf_layout_2/o1 7.144f
C109 VAPWR buf_layout_2/tail 40.274f
C110 VAPWR comp_layout_0/CLK 9.627f
C111 VAPWR comp_layout_0/Q 5.228f
C112 VAPWR comp_layout_0/di1 3.72f
C113 VAPWR comp_layout_0/di2 2.103f
C114 VAPWR comp_layout_0/n1b 3.417f
C115 VAPWR comp_layout_0/n2b 2.654f
C116 VAPWR comp_layout_0/on1 2.877f
C117 VAPWR comp_layout_0/on2 3.856f
C118 VAPWR comp_layout_0/sb 0.884f
C119 VAPWR comp_layout_0/sq 0.628f
C120 VAPWR comp_layout_0/tail 3.06f
C121 VAPWR dff_layout_0/CLK 12.314f
C122 VAPWR dff_layout_0/D 10.404f
C123 VAPWR dff_layout_0/Q 1.837f
C124 VAPWR dff_layout_0/QB 7.89f
C125 VAPWR dff_layout_0/clkb 4.175f
C126 VAPWR dff_layout_0/mb 3.925f
C127 VAPWR dff_layout_0/mfb 2.219f
C128 VAPWR dff_layout_0/mi 3.529f
C129 VAPWR dff_layout_0/sfb 2.326f
C130 VAPWR dff_layout_0/si 2.875f
C131 VAPWR lvl_layout_0/n1 7.862f
C132 VAPWR lvl_layout_0/n2 7.201f
C133 VAPWR lvl_layout_0/nb18 0.233f
C134 VAPWR odrv_layout_0/a 0.054f
C135 VAPWR odrv_layout_0/b 0
C136 VAPWR ota_layout_0/INM 1.134f
C137 VAPWR ota_layout_0/INP 20.196f
C138 VAPWR ota_layout_0/IREFN 10.838f
C139 VAPWR ota_layout_0/IREFP 352.35f
C140 VAPWR ota_layout_0/VBNC 13.859f
C141 VAPWR ota_layout_0/VBPC 15.35f
C142 VAPWR ota_layout_0/dio 21.62f
C143 VAPWR ota_layout_0/fn1 4.348f
C144 VAPWR ota_layout_0/fn2 1.814f
C145 VAPWR ota_layout_0/pc1 14.108f
C146 VAPWR ota_layout_0/pc2 17.76f
C147 VAPWR ota_layout_0/tail 52.125f
C148 VDPWR VGND 61.075f
C149 VDPWR buf_layout_2/OUT 6.302f
C150 VDPWR comp_layout_0/CLK 0.328f
C151 VDPWR comp_layout_0/Q 0
C152 VDPWR comp_layout_0/on2 0.169f
C153 VDPWR dff_layout_0/CLK 0.063f
C154 VDPWR dff_layout_0/D 5.166f
C155 VDPWR dff_layout_0/Q 4.988f
C156 VDPWR dff_layout_0/QB 5.359f
C157 VDPWR dff_layout_0/mb 0.011f
C158 VDPWR dff_layout_0/mi 0.019f
C159 VDPWR lvl_layout_0/n1 0.089f
C160 VDPWR lvl_layout_0/nb18 2.476f
C161 VDPWR odrv_layout_0/a 6.857f
C162 VDPWR odrv_layout_0/b 8.915f
C163 VDPWR odrv_layout_1/a 6.907f
C164 VDPWR odrv_layout_1/b 8.74f
C165 VDPWR ota_layout_0/IREFP 0.009f
C166 VDPWR ota_layout_0/VBNC 0.499f
C167 VDPWR ota_layout_0/VBPC 4.612f
C168 VGND bias_layout_0/ind 4.899f
C169 VGND bias_layout_0/ipd 22.535f
C170 VGND bias_layout_0/nb 62.854f
C171 VGND bias_layout_0/nst 8.975f
C172 VGND bias_layout_0/pb 12.663f
C173 VGND bias_layout_0/rs 3.593f
C174 VGND bias_layout_0/vbnc_i 38.696f
C175 VGND bias_layout_0/vbpc_i 17.079f
C176 VGND buf_layout_0/IN 7.248f
C177 VGND buf_layout_0/OUT 119.47f
C178 VGND buf_layout_0/o1 18.18f
C179 VGND buf_layout_0/tail 6.843f
C180 VGND buf_layout_1/IN 11.671f
C181 VGND buf_layout_1/o1 18.62f
C182 VGND buf_layout_1/tail 6.801f
C183 VGND buf_layout_2/IN 11.6f
C184 VGND buf_layout_2/OUT 120.42f
C185 VGND buf_layout_2/o1 18.067f
C186 VGND buf_layout_2/tail 6.737f
C187 VGND comp_layout_0/CLK 21.446f
C188 VGND comp_layout_0/Q 10.727f
C189 VGND comp_layout_0/di1 3.828f
C190 VGND comp_layout_0/di2 2.918f
C191 VGND comp_layout_0/n1b 5.322f
C192 VGND comp_layout_0/n2b 2.97f
C193 VGND comp_layout_0/on1 8.346f
C194 VGND comp_layout_0/on2 9.693f
C195 VGND comp_layout_0/sb 2.721f
C196 VGND comp_layout_0/sq 2.572f
C197 VGND comp_layout_0/tail 2.119f
C198 VGND dff_layout_0/CLK 14.115f
C199 VGND dff_layout_0/D 23.552f
C200 VGND dff_layout_0/Q 10.775f
C201 VGND dff_layout_0/QB 13.934f
C202 VGND dff_layout_0/clkb 10.765f
C203 VGND dff_layout_0/mb 4.946f
C204 VGND dff_layout_0/mfb 4.093f
C205 VGND dff_layout_0/mi 7.037f
C206 VGND dff_layout_0/sfb 2.733f
C207 VGND dff_layout_0/si 7.165f
C208 VGND lvl_layout_0/n1 14.371f
C209 VGND lvl_layout_0/n2 11.101f
C210 VGND lvl_layout_0/nb18 14.007f
C211 VGND odrv_layout_0/a 9.366f
C212 VGND odrv_layout_0/b 7.791f
C213 VGND odrv_layout_1/a 9.363f
C214 VGND odrv_layout_1/b 7.805f
C215 VGND ota_layout_0/INM 34.369f
C216 VGND ota_layout_0/INP 125.12f
C217 VGND ota_layout_0/IREFN 104.75f
C218 VGND ota_layout_0/IREFP 51.939f
C219 VGND ota_layout_0/VBNC 90.064f
C220 VGND ota_layout_0/VBPC 89.992f
C221 VGND ota_layout_0/dio 10.564f
C222 VGND ota_layout_0/fn1 21.08f
C223 VGND ota_layout_0/fn2 18.5f
C224 VGND ota_layout_0/pc1 0.938f
C225 VGND ota_layout_0/pc2 1.156f
C226 VGND ota_layout_0/tail 123.24f
C227 VGND rdac_0/X0/R1 6.016f
C228 VGND sw_nmos_2/X0/D 2.097f
C229 VGND sw_nmos_4/X0/D 2.102f
C230 bias_layout_0/ind bias_layout_0/ipd 2.746f
C231 bias_layout_0/ind bias_layout_0/nb 1.066f
C232 bias_layout_0/ind bias_layout_0/nst 0.216f
C233 bias_layout_0/ind bias_layout_0/pb 13.604f
C234 bias_layout_0/ind bias_layout_0/rs 0.163f
C235 bias_layout_0/ind bias_layout_0/vbnc_i 1.932f
C236 bias_layout_0/ind bias_layout_0/vbpc_i 9.398f
C237 bias_layout_0/ind ota_layout_0/INP 0.017f
C238 bias_layout_0/ind ota_layout_0/IREFN 20.668f
C239 bias_layout_0/ind ota_layout_0/IREFP 0.271f
C240 bias_layout_0/ind ota_layout_0/VBNC 0.211f
C241 bias_layout_0/ind ota_layout_0/VBPC 0.217f
C242 bias_layout_0/ipd bias_layout_0/nb 16.677f
C243 bias_layout_0/ipd bias_layout_0/nst 0.132f
C244 bias_layout_0/ipd bias_layout_0/pb 0.47f
C245 bias_layout_0/ipd bias_layout_0/rs 0.17f
C246 bias_layout_0/ipd bias_layout_0/vbnc_i 10.575f
C247 bias_layout_0/ipd bias_layout_0/vbpc_i 3.802f
C248 bias_layout_0/ipd ota_layout_0/INP 0.022f
C249 bias_layout_0/ipd ota_layout_0/IREFN 0.258f
C250 bias_layout_0/ipd ota_layout_0/IREFP 25.106f
C251 bias_layout_0/ipd ota_layout_0/VBNC 0.217f
C252 bias_layout_0/ipd ota_layout_0/VBPC 0.21f
C253 bias_layout_0/nb bias_layout_0/nst 5.026f
C254 bias_layout_0/nb bias_layout_0/pb 10.353f
C255 bias_layout_0/nb bias_layout_0/rs 5.516f
C256 bias_layout_0/nb bias_layout_0/vbnc_i 0.876f
C257 bias_layout_0/nb bias_layout_0/vbpc_i 5.112f
C258 bias_layout_0/nb ota_layout_0/INP 0.062f
C259 bias_layout_0/nb ota_layout_0/IREFN 2.721f
C260 bias_layout_0/nb ota_layout_0/IREFP 0.004f
C261 bias_layout_0/nb ota_layout_0/VBNC 0.692f
C262 bias_layout_0/nb ota_layout_0/VBPC 0.866f
C263 bias_layout_0/nst bias_layout_0/pb 3.093f
C264 bias_layout_0/nst bias_layout_0/rs 0.374f
C265 bias_layout_0/nst bias_layout_0/vbnc_i 0.984f
C266 bias_layout_0/nst bias_layout_0/vbpc_i 4.076f
C267 bias_layout_0/nst ota_layout_0/INP 0.042f
C268 bias_layout_0/nst ota_layout_0/IREFP 0.001f
C269 bias_layout_0/nst ota_layout_0/VBNC 0.032f
C270 bias_layout_0/nst ota_layout_0/VBPC 0.036f
C271 bias_layout_0/pb bias_layout_0/rs 10.281f
C272 bias_layout_0/pb bias_layout_0/vbnc_i 3.48f
C273 bias_layout_0/pb bias_layout_0/vbpc_i 2.01f
C274 bias_layout_0/pb dff_layout_0/CLK 0
C275 bias_layout_0/pb dff_layout_0/QB 0
C276 bias_layout_0/pb dff_layout_0/mb 0
C277 bias_layout_0/pb dff_layout_0/mi 0
C278 bias_layout_0/pb dff_layout_0/si 0
C279 bias_layout_0/pb ota_layout_0/INP 0.071f
C280 bias_layout_0/pb ota_layout_0/IREFN 0.025f
C281 bias_layout_0/pb ota_layout_0/IREFP 0
C282 bias_layout_0/pb ota_layout_0/VBNC 2.847f
C283 bias_layout_0/pb ota_layout_0/VBPC 0.824f
C284 bias_layout_0/rs bias_layout_0/vbnc_i 6.385f
C285 bias_layout_0/rs bias_layout_0/vbpc_i 0.238f
C286 bias_layout_0/rs dff_layout_0/CLK 0
C287 bias_layout_0/rs dff_layout_0/clkb 0
C288 bias_layout_0/rs ota_layout_0/INP 0.053f
C289 bias_layout_0/rs ota_layout_0/IREFP 0.002f
C290 bias_layout_0/rs ota_layout_0/VBNC 1.662f
C291 bias_layout_0/rs ota_layout_0/VBPC 0.251f
C292 bias_layout_0/vbnc_i bias_layout_0/vbpc_i 7.437f
C293 bias_layout_0/vbnc_i buf_layout_0/OUT 0.001f
C294 bias_layout_0/vbnc_i buf_layout_1/o1 0
C295 bias_layout_0/vbnc_i buf_layout_1/tail 0.005f
C296 bias_layout_0/vbnc_i buf_layout_2/OUT 0.001f
C297 bias_layout_0/vbnc_i buf_layout_2/o1 0
C298 bias_layout_0/vbnc_i dff_layout_0/CLK 0.038f
C299 bias_layout_0/vbnc_i dff_layout_0/D 0.007f
C300 bias_layout_0/vbnc_i dff_layout_0/QB 0
C301 bias_layout_0/vbnc_i dff_layout_0/clkb 0.003f
C302 bias_layout_0/vbnc_i dff_layout_0/mb 0
C303 bias_layout_0/vbnc_i dff_layout_0/mi 0.004f
C304 bias_layout_0/vbnc_i dff_layout_0/si 0
C305 bias_layout_0/vbnc_i ota_layout_0/INP 0.428f
C306 bias_layout_0/vbnc_i ota_layout_0/IREFN 0.041f
C307 bias_layout_0/vbnc_i ota_layout_0/IREFP 10.292f
C308 bias_layout_0/vbnc_i ota_layout_0/VBNC 7.041f
C309 bias_layout_0/vbnc_i ota_layout_0/VBPC 0.141f
C310 bias_layout_0/vbpc_i buf_layout_0/OUT 0
C311 bias_layout_0/vbpc_i buf_layout_2/OUT 0
C312 bias_layout_0/vbpc_i dff_layout_0/CLK 0.005f
C313 bias_layout_0/vbpc_i dff_layout_0/Q 0
C314 bias_layout_0/vbpc_i dff_layout_0/QB 0.006f
C315 bias_layout_0/vbpc_i dff_layout_0/clkb 0.003f
C316 bias_layout_0/vbpc_i dff_layout_0/mb 0.004f
C317 bias_layout_0/vbpc_i dff_layout_0/mfb 0.002f
C318 bias_layout_0/vbpc_i dff_layout_0/mi 0.002f
C319 bias_layout_0/vbpc_i dff_layout_0/sfb 0.002f
C320 bias_layout_0/vbpc_i dff_layout_0/si 0.007f
C321 bias_layout_0/vbpc_i ota_layout_0/INP 0.515f
C322 bias_layout_0/vbpc_i ota_layout_0/IREFN 9.076f
C323 bias_layout_0/vbpc_i ota_layout_0/IREFP 0.359f
C324 bias_layout_0/vbpc_i ota_layout_0/VBNC 0.398f
C325 bias_layout_0/vbpc_i ota_layout_0/VBPC 6.918f
C326 buf_layout_0/IN buf_layout_0/OUT 0.044f
C327 buf_layout_0/IN buf_layout_0/o1 3.659f
C328 buf_layout_0/IN buf_layout_0/tail 3.577f
C329 buf_layout_0/IN buf_layout_1/IN 0.82f
C330 buf_layout_0/IN buf_layout_1/o1 0.124f
C331 buf_layout_0/IN buf_layout_1/tail 0.218f
C332 buf_layout_0/IN buf_layout_2/IN 5.24f
C333 buf_layout_0/IN buf_layout_2/OUT 1.431f
C334 buf_layout_0/IN buf_layout_2/o1 0.118f
C335 buf_layout_0/IN buf_layout_2/tail 0.152f
C336 buf_layout_0/IN ota_layout_0/INP 0.313f
C337 buf_layout_0/IN ota_layout_0/IREFP 0.899f
C338 buf_layout_0/OUT buf_layout_0/o1 9.17f
C339 buf_layout_0/OUT buf_layout_0/tail 11.218f
C340 buf_layout_0/OUT buf_layout_1/o1 0.001f
C341 buf_layout_0/OUT buf_layout_2/OUT 25.615f
C342 buf_layout_0/OUT comp_layout_0/CLK 0.094f
C343 buf_layout_0/OUT comp_layout_0/Q 0.415f
C344 buf_layout_0/OUT comp_layout_0/tail 0.009f
C345 buf_layout_0/OUT dff_layout_0/CLK 0.077f
C346 buf_layout_0/OUT dff_layout_0/D 0.407f
C347 buf_layout_0/OUT ota_layout_0/INM 1.136f
C348 buf_layout_0/OUT ota_layout_0/INP 0.431f
C349 buf_layout_0/OUT ota_layout_0/IREFN 0.345f
C350 buf_layout_0/OUT ota_layout_0/IREFP 6.373f
C351 buf_layout_0/OUT ota_layout_0/VBNC 0.268f
C352 buf_layout_0/OUT ota_layout_0/VBPC 0.133f
C353 buf_layout_0/OUT ota_layout_0/fn2 0.235f
C354 buf_layout_0/OUT ota_layout_0/tail 0.259f
C355 buf_layout_0/OUT rdac_0/X0/R1 0.69f
C356 buf_layout_0/OUT sw_nmos_2/X0/D 0.077f
C357 buf_layout_0/OUT sw_nmos_4/X0/D 1.011f
C358 buf_layout_0/o1 buf_layout_0/tail 8.759f
C359 buf_layout_0/o1 buf_layout_1/o1 0.055f
C360 buf_layout_0/o1 buf_layout_2/OUT 0.081f
C361 buf_layout_0/o1 ota_layout_0/INP 0
C362 buf_layout_0/o1 ota_layout_0/IREFP 0.881f
C363 buf_layout_0/tail buf_layout_1/o1 0.026f
C364 buf_layout_0/tail buf_layout_2/OUT 0.116f
C365 buf_layout_0/tail ota_layout_0/IREFP 25.774f
C366 buf_layout_1/IN buf_layout_1/o1 3.659f
C367 buf_layout_1/IN buf_layout_1/tail 3.577f
C368 buf_layout_1/IN buf_layout_2/IN 1.542f
C369 buf_layout_1/IN buf_layout_2/OUT 0.802f
C370 buf_layout_1/IN buf_layout_2/o1 0.219f
C371 buf_layout_1/IN buf_layout_2/tail 0.087f
C372 buf_layout_1/IN ota_layout_0/INP 0.603f
C373 buf_layout_1/IN ota_layout_0/IREFP 0.57f
C374 buf_layout_1/o1 buf_layout_1/tail 8.759f
C375 buf_layout_1/o1 buf_layout_2/IN 0.007f
C376 buf_layout_1/o1 buf_layout_2/OUT 0.155f
C377 buf_layout_1/o1 buf_layout_2/o1 0.055f
C378 buf_layout_1/o1 ota_layout_0/INP 8.429f
C379 buf_layout_1/o1 ota_layout_0/IREFP 0.882f
C380 buf_layout_1/tail buf_layout_2/IN 0.224f
C381 buf_layout_1/tail buf_layout_2/OUT 0.127f
C382 buf_layout_1/tail buf_layout_2/o1 0.026f
C383 buf_layout_1/tail ota_layout_0/INP 11.241f
C384 buf_layout_1/tail ota_layout_0/IREFP 25.927f
C385 buf_layout_2/IN buf_layout_2/OUT 0.446f
C386 buf_layout_2/IN buf_layout_2/o1 3.776f
C387 buf_layout_2/IN buf_layout_2/tail 3.803f
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
