pthomas/ttsky-sigma-delta/mag/rl_cm.spice

* NGSPICE file created from rl_cm.ext - technology: sky130A

.subckt sky130_fd_pr__res_high_po_1p41_HQBJZB B R1 R2
X0 R2 R1 B sky130_fd_pr__res_high_po_1p41 l=216.23
.ends

.subckt rl_cm
XX0 VSUBS X0/R1 X0/R2 sky130_fd_pr__res_high_po_1p41_HQBJZB
.ends
