pthomas/ttsky-sigma-delta/(commit log)

2026-07-06 Tier-1 behavioral CT sigma-delta: xschem schematic, ngspice sim, SNDR analysis
    params.py -> spice/params.spice -> xschem netlist -> ngspice -> sim/snr.py
    First results @ fs=50MHz: 6.1 ENOB @ 1MHz BW, ~12 ENOB @ 100kHz BW (coarse).
    [tier1_sdm.sch]
2026-07-06 Redraw tier-1 schematic textbook-style with totem-pole RZ DAC
    Custom symbols (opamp/comparator triangles, DFF box), continuous signal-flow
    wiring, explicit switch DAC replacing the ideal B-source. Same SNDR results.
    xschem authoring gotchas recorded in DESIGN.md.
    [tier1_sdm.sch]
2026-07-08 Fix schematic layout: sources row clear of signal path, DAC labels de-cluttered
    Source column labels (vrefp/vrefn/vcm) previously poked into the signal row,
    making the comparator look tied to vrefp and the DFF clock to vrefn.
    Netlist unchanged; SNDR unchanged (6.2 / 11.7 ENOB).
    [tier1_sdm.sch]
2026-07-18 NRZ vs RZ comparison pipeline: RZ confirmed; 1st-order pattern noise characterized
    make report: 4 paired variants ({rz,nrz} x {sym,asym} switch ron) with
    equalized feedback charge and pinned dither seed -> reports/dac_compare.html.
    NRZ loses ~9 dB precision SNDR at ~190 ps edge asymmetry; RZ stays within
    pattern-noise scatter (+-1 dB run-to-run; chaotic loop, seed-pinned).
    sim/tier0.py: ideal DT model for long-run tone statistics.
2026-07-18 Interactive xschem scope flow + all-NMOS DAC decision
    - Simulate button runs terminal-less ngspice batch (xterm not installed)
    - embedded waveform graphs + LOAD WAVES launcher in tier1_sdm.sch
    - xschemrc stub in xschem/ so any launch directory works
    - DESIGN.md: RZ decision data, pattern-noise findings, all-NMOS switches
    with lowered reference window (open item 6), 1/f renumbered to 7
    [tier1_sdm.sch]
2026-07-18 TT platform facts: target TTSKY26c (deadline 2026-09-07), I/O limits resolved
    Outputs max 33 MHz -> bitstream needs 2-phase demux to keep fs=50MHz (item 1b);
    clk arrives in 1.8V domain -> level shifter joins block list; analog pin
    path specs check out against RIN=40k.
2026-07-18 sky130 device characterization: reference window 0.4/0.9/1.4V confirmed by data
    make char -> reports/fet_char.html: gm/Id curves (L=0.5/1/2um, both 3.3V fets)
    and pass-switch ron vs passed voltage. NMOS ron flat 229-441 ohm across the
    proposed window vs 35k at old VREFP=2.15V. Vth(cc): nfet 0.86V, pfet 1.10V ->
    1.8V gate drive unusable, clk level shifter mandatory. xschemrc now exposes
    the PDK xschem library.
2026-07-18 OTA requirements from tier-1 sweeps: AOL>=300, GBW>=50MHz (!), SR>=100V/us
    Behavioral OTA upgraded to single-pole slew-limited model (AOL/GBW/SR in
    params.py). make specs sweeps each vs SNDR on both paths. GBW surprisingly
    non-binding (linear settling errors = gain error only, delayed-RZ settles
    residue); slew is the binding constraint. Block requirements table added to
    DESIGN.md; first-cut folded cascode ~250uA / 1.7mW clears all targets.
    [tier1_sdm.sch]
2026-07-18 Tier-2 OTA v1: folded cascode sized in sky130, meets spec table
    sim/ota_tb.py: parameterized subckt + 3-in-1 testbench (AC open loop, slew
    step, buffer range). Converged at A0 65dB, GBW 209MHz, PM 58deg, slew
    +197/-253 V/us, 4.5mW @ tt. Sizing lessons + output-floor/window coupling
    recorded in DESIGN.md (integrator swing must shrink to ~0.65-1.15V).
2026-07-18 CINT=2p: integrator swing VCM+-0.22V confirmed, input FS unchanged; area budget
    Tier-1 verified: SNDR unchanged with halved feedback step, swing fits the
    cascode output floor. Area estimate ~18k um2 = 50% of a 1x2 tile for 1st
    order; 2x2 recommended if 2nd order/differential is the goal. Input
    conditioning logged as open item 7 (passive virtual-ground scaling first).
2026-07-18 OTA v1 corner sweep: flat across tt/ss/ff/sf/fs, sizes frozen for layout
    A0 64.6-65.4dB, GBW 199-220MHz, PM 56-59deg, SR+ 190-204V/us, 4.5mW.
    Caveats noted: ideal bias sources, no temp sweep yet, PM ~2-4deg under bar.
2026-07-18 CI: one job per make target with report artifacts; char honors PDK_ROOT
    Loose fast-path SNDR floor (>=35 dB) only -- precision numbers scatter by
    design. Jobs: snr + fet-char (smoke), dac-report + ota-specs (reports).
2026-07-18 OTA xschem schematic generated from frozen sizes; equivalence proven
    tools/gen_ota_sch.py emits xschem/ota.sch from sim/ota_tb.py SIZES (one
    source of truth). ota.sym + ota_top.sch wrapper netlist the .subckt;
    sim/ota_xcheck.py runs the AC testbench on the xschem netlist: A0/GBW/PM
    identical to inline reference (65.2dB/209MHz/58deg). make xcheck.
    Gotcha recorded: PDK pfet symbols are source-up (D/S mirrored vs nfet).
    [ota.sch, ota_top.sch]
2026-07-18 First layout cells in magic: rin/rdac/cint/sw_nmos, values verified by extraction
    make layout: gencell serpentine resistors with auto length calibration
    (40.11k/20.02k, <0.5% err), 2x25x20um MiM cap (2.03pF), guarded DAC switch
    nfet 10/0.5. Requires source-built magic (8.3.676 on dev machine).
2026-07-18 OTA layout phase 1: bbox-driven placement of 13 fingered devices, DRC clean
    204x65um floorplan, unit-finger convention matches schematic (w=5, nf=mult).
    Lessons: gencell w is per-finger; extraction merge pending routing phase.
    Routing + LVS (needs source-built netgen) is phase 2.
2026-07-19 OTA layout routed: 13/13 devices match golden netlist by extraction
    Generated placement + netlist-driven routing (met2 column grouping, met3
    risers, met1 tracks, globally unique riser slots, cross-net paint audit).
    Key discoveries in DESIGN.md: gencell full_metal pre-straps columns, the
    three coordinate systems, per-finger w. DRC cleanup + netgen LVS next.
2026-07-19 OTA layout LVS CLEAN: netgen 'Circuits match uniquely' vs xschem golden
    Bulk taps needed full mcon stack (guard rings are li-only); pin ports via
    ext2spice subcircuit top on; make lvs target added.
2026-07-19 OTA layout DRC CLEAN: the 894 'violations' were a magic writeall artifact
    Root cause (proven by isolated load+writeall experiment): magic 8.3.676's
    'writeall force' rewrites unmodified gencell subcells lambda-normalized
    without their magscale header, halving odd 0.005um coordinates lossily.
    The gencells' exact 0.235um licon.9+psdm.5a gap (47 internal units) became
    46 units on reload; ~117 width slivers were the same rounding. Both prior
    root-cause hypotheses (strap ty±1.5 offset, guard-ring corner) were wrong:
    the offending shapes are device-internal, untouched by routing paint.
    route_ota.py now saves only the painted parent cell and re-verifies DRC on
    the saved files in a fresh magic proc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
2026-07-19 OTA PEX: extracted-netlist TB shows A0 65dB / GBW 119MHz / PM 46deg
    tools/pex_ota.py: fresh-process magic extraction with all parasitic caps
    (cthresh 0, C-only), no writes back into mag/. sim/ota_tb.py --pex wraps
    the extracted ota_layout subckt to the same 5-pin interface (ideal refs
    supplied externally, matching the schematic subckt's internal bias).
    make pex runs both.
    vs schematic: A0/Ivdd/op unchanged; GBW 209->119 MHz, PM 58->46 deg,
    SR +197->+128 V/us from 0.72 pF routing self-load. All measured tier-1
    knees (A0>=49.5dB, GBW>=50MHz, SR>=100V/us) still met with >=2x margin;
    PM has no measured knee yet - decision on whether 46 deg suffices is
    parked in STATUS.md next actions.
    Co-Autho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
2026-07-19 PM knee measured: none down to 28 deg; extracted OTA (46 deg) accepted
    Tier-1 behavioral OTA gains a buffered second pole (FP2 in params.py,
    baseline 100 GHz = none); make specs sweeps it 50 MHz-2 GHz with each
    point labeled by equivalent unity-gain phase margin (28-84 deg). SNDR is
    flat within pattern-noise scatter on both paths: excess phase is linear
    dynamics and aliases to gain error, same mechanism as the GBW non-result.
    OTA layout closed for v1.
    Supporting findings, logged in DESIGN.md:
    - tier-1 deck now uses gear integration: default trap rings on the FP2
    stage's fast state (~2/8 dB fake SNDR loss fast/precision); precision
    baseline is now 64.8 dB, consistent with the ~66 dB long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
    [tier1_sdm.sch]
2026-07-19 StrongARM comparator v1: PMOS input, tau 69ps, decides in ~1ns (tt)
    PMOS input pair completes the open-item-6 logic (window moved low so NMOS
    passes it -> PMOS senses it, same rule as the OTA input pair): ~1.5V of
    overdrive at the 0.9V CM where an NMOS pair would sit at threshold, and
    it gets faster at the 0.68V swing floor where NMOS dies. Mirrored
    StrongARM (clocked PMOS tail, evaluate on CLK low, precharge-to-VSS,
    NOR SR latch), single-phase clock.
    sim/comp_tb.py measures per (CM, overdrive) point in its own ngspice
    process: decision time on the raw regeneration nodes, sign correctness
    (enforced >=10mV; below that both solver noise and silicon offset own
    the verdict, and the 1-bit loop t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
2026-07-19 Comparator complete + DFF retimer + docs visuals; latch hysteresis bug fixed
    Circuit: the NOR SR latch wired directly to the regeneration nodes was a
    real bug - its held state presents asymmetric Miller loading, a ~10mV
    dynamic hysteresis seeded by the PREVIOUS decision (measured as
    state-dependent wrong-sign flips that survived every solver fix). Now
    inverter-buffered into a NAND SR latch, textbook style: monotone race,
    sign-correct at every enforced point in all 5 corners (tau 63-97ps,
    worst 1.18ns). Offset MC (tt_mm via per-sample .spiceinit rndseed,
    bisection trip search): sigma 13.6mV N=19 - benign DC shift in a 1-bit
    loop. xschem schematic generated from SIZES (tools/gen_comp_sch.py),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
    [comp.sch, comp_top.sch]
2026-07-19 Reference window retune (open item 6) + report notes round 2
    params.py refs now 0.4/0.9/1.4 V (spans preserved -> k, FS unchanged).
    Tier-1 at the new window: 39.1/66.6 dB, integrator swing 0.685-1.117 V,
    on target. Fixed a latent domain bug the move exposed: comp_beh output
    was VCM-centered (analog) while the DFF thresholds at the digital
    mid-rail - now pinned to 1.65 V explicitly.
    Report: acronyms expanded on first use throughout; PEX chapter retitled;
    anchors moved onto headings with scroll margin; references chapter
    (Schreier/Temes, Boser/Wooley, Cherry/Snelgrove, Razavi, Ortmanns/
    Gerfers) with footnote markers on definitive claims; tier-1 zoom panel
    now shows integrator -> comparator -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
    [tier1_sdm.sch]
2026-07-19 OTA re-floorplanned for the TinyTapeout 1x2 tile (119x73 um, was 204 wide)
    MT/MDP stacked on separate rows: side by side the floorplan was 204 um
    wide, wider than the 1x2 tile interior (~145 um). Router slot search now
    widens progressively when the nominal +-4 um range is exhausted (stacked
    rows pile gate taps at the same x). route_ota now refuses to run on an
    already-routed ota_layout.mag (re-routing double-paints and shorts -
    regenerate placement first). Verified: 13/13 devices, DRC 0 fresh-process,
    LVS "Circuits match uniquely".
2026-07-19 Bias generator v1: constant-gm core + cascoded mirrors, ACCEPTED vs golden OTA
    Beta-multiplier master (~19uA, RB-set), 19x/17x cascoded reference
    mirrors (cascode gates reuse the block's own VBNC/VBPC), resistor-ratio
    cascode bias voltages, startup leaker with VBNC-gated steal-away disable.
    Measured on the way (DESIGN.md log): uncascoded 5V mirrors ran 43% hot
    (soft saturation, again); an always-on "weak" startup leaker is 3.4uA =
    17% master error at Vsg 2.45V; PMOS pass bulk to VSS = forward junction,
    core never starts.
    Acceptance with the real bias replacing all four ideal sources: tt A0
    65.4dB / GBW 194MHz / PM 57deg (ideal-bias: 65.2/209/58); ss/ff tighter
    than ideal-bias corners (cons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
2026-07-19 Absorb the TinyTapeout submission into this repo (GitHub becomes a mirror)
    This repo is now simultaneously the design workspace and the TT project:
    info.yaml + src/ + gds/ + lef/ + tt_frame/ + docs/info.md + the TT
    GitHub Actions (which run on the GitHub mirror and gate precheck).
    make tt rebuilds the submission frame from mag/. Apache-2.0 LICENSE
    added (TT requirement; overdue for a public repo anyway). README for
    the combined identity.
2026-07-19 Reference-buffer spec measured: RREF knee is soft (<=300 ohm w/ 20pF decap)
    New RREF axis in the tier-1 spec sweep: references driven through source
    impedance + 20pF decap. Fast path flat to 10k; precision inside normal
    scatter to ~1k, broken at 10k. The decap carries the 10ns DAC pulses;
    the buffer only recharges it. Spec: Rout <= 300 ohm (target <= 100) with
    >= 20pF per reference.
2026-07-19 Reference buffers v1: three 5T unity followers, ACCEPTED vs the RREF knee
    One PMOS-input 5T design at 0.4/0.9/1.4 V, 320uA tail each, 20pF decap.
    Zout 754 ohm (spec <=1k = 10x under true breakage; the earlier 300-ohm
    figure was margin-on-margin and 3x the power). Bit-dependent residuals
    6.9mV (VREFP/N) / 2.2mV (VCM), corners flat, 3.2mW total. DC offsets
    <=39mV are the 5T systematic mirror-Vds error - pure reference gain/
    offset, documented not fought. TB lesson logged: the VCM return load is
    ~2ns edge transients, not sustained half-period pulses (DAC node sits AT
    VCM during the return phase).
2026-07-19 Clock level shifter v1 + report round 3 (readable schematics, 4x1 loop trip)
    Level shifter: cross-coupled 1.8->3.3V, thin-oxide input stage, corners
    x VDPWR sweep: full swing, <1ns delay, duty error <=2.42% (gate 3% --
    static duty is a benign bit-independent gain shift per the tier-1 knee
    taxonomy; bit-dependent width variation is zero by construction). ~300uW.
    Report: schematic generators now draw the branch wiring and supply rails
    so the OTA reads as a folded cascode and the comparator as a StrongARM
    (equivalence checks still MATCH -- lab_pins remain the netlist
    authority); tier-1 schematic export cropped to the circuit region with
    the model text covered in prose; new 4x1 loop-trip figure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
    [comp.sch, ota.sch]
2026-07-19 STATUS: level shifter done; output drivers remain
2026-07-19 Output drivers v1 (last block!) + IO decisions logged + drop q strip chart
    Output drivers: 3.3->1.8V level-down with a 5V-gate first stage on the
    1.8V rail (no thin-oxide overstress) + thin-oxide buffers, complementary
    Q/QB to uo[0]/uo[1] ("pseudo-LVDS" at the FPGA receiver). ACCEPT first
    pass: full swing, <=0.4ns, skew <=407ps, duty ~51%, ~180uW, corners x
    VDPWR. IO decisions logged: 2-phase demux REJECTED (fallback = lower fs),
    no differential path this design, true LVDS dropped.
    Report: bitstream strip chart removed -- the 4x1 loop trip tells it.
    CI: odrv added to support-blocks.
    ALL BLOCKS NOW DESIGNED AND VERIFIED: OTA (laid out + PEX), comparator,
    retimer, bias, references, level shi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
2026-07-19 STATUS: assembly-campaign handoff (context reset prep)
    Full ordered plan for the layout/assembly arc with the session context a
    fresh instance needs: decap area problem + validation recipe, reference
    ladder gap, layout-flow gotchas, top-level netlist, sub-pages spec, TT
    finalization checklist.
2026-07-19 Reference plan fix: CDEC 20->5 pF (tier-1 validated) + VAPWR ladder
    3x20 pF MiM didn't fit the tile; tier-1 at RREF=754 shows CDEC
    20/10/5/2 pF all inside precision-path scatter (smaller C = faster
    recovery = less true ISI). buf_tb.py: CDEC=5p, 190k/50k/50k/40k ladder
    off VAPWR feeding the buffer gates, isi metric now samples the
    pulse-inherited state instead of period-end (which false-failed small
    decaps by measuring bit-independent droop). ACCEPT: bit-dep <=2.5 mV,
    DC <=39 mV, 3.2 mW.
2026-07-20 Support-block goldens + generated schematics + canonical equivalence
    make blockcheck: gen_golden.py emits spice/golden/<b>.spice from the TB
    SIZES dicts (bias with real poly-R/MiM cards -- lengths calibrated
    against the ngspice model, which carries a 256-ohm end resistance magic's
    sheet rho does not; RNB isolation Rs 100->1k, below the realizable
    floor). gen_sch.py draws dff/bias/buf/lvl/odrv schematics from device
    tables; xcheck_blocks.py requires device-for-device identity + exact
    port order vs the goldens (ALL MATCH, all 6 blocks). buf tail: ideal
    ITAIL -> real PMOS mirror (mult 64) off the OTA IREFP diode line;
    re-ACCEPTed. CI support-blocks runs bias --layout + blockcheck.
    Co-Authored-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
    [bias.sch, bias_top.sch, buf.sch, buf_top.sch, dff.sch, dff_top.sch, lvl.sch, lvl_top.sch]
2026-07-20 All six support-block layouts DRC 0 + LVS clean (shared lay_lib)
    tools/lay_lib.py: golden-driven placement (gencells from the golden
    cards), straps/taps/m3 risers/m1 tracks, same-net tap merging, fresh-
    process DRC, structural compare, netgen LVS. tools/gen_block_layouts.py
    holds per-block row plans. comp 67x22, dff 58x22, bias 86x113, buf
    85x33, lvl 38x26, odrv 9x55 um.
    Empirical rules that got here (full log in DESIGN.md): thin-oxide
    L=0.15 unbuildable under the strap scheme (lvl/odrv -> L=0.35, W
    scaled, TBs re-ACCEPT); G taps = upward m1 flag + via (gencell G m1 is
    a sub-via mosaic); res taps = via1 on the gencell's end m1 only;
    same-net taps merge into one bar+riser (supplies are 70% o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
    [bias.sch, lvl.sch, odrv.sch]
2026-07-20 Assembly prep: passive cells (ladder/decap/filter), block reshapes, 2x2 def
    gen_layout_cells: model-calibrated ladder Rs (rl_top/pc/cm/bot, extracted
    leff hits the ngspice-model target incl. snake-corner correction), cdec
    5pF, cflt 1pF. buf tail split into 2x nf=32 (44x43 vs 85x33), odrv single
    row (31x29) -- both re-verified DRC 0 + LVS. tt_analog_2x2_3v3.def
    fetched: measured block areas total ~46k um^2 vs ~27k usable in 1x2 --
    the 1x2 tile cannot fit the full modulator; targeting 2x2 (user decision
    on tile purchase flagged).
    [bias.sch, buf.sch]
2026-07-20 Passive cell final sizing (CDEC 5->2 pF) + golden top-netlist generator
    CDEC settled at 2 pF/reference after tier-1 confirmed the 5 pF bricks
    don't fit the 2x2 floorplan (DESIGN.md 2026-07-19); regenerated the
    ladder R and decap/filter MiM gencells accordingly, including their
    child .mag files (writeall force now saves gencell subcells to disk,
    not just the parent). tools/gen_top_golden.py stitches the block
    goldens + passive device cards into spice/golden/top.spice, the LVS
    reference for top-level assembly.
    Also: drop a stray kate swap file, fix a runner-registration typo in
    ci/lxd/readme.rst.
2026-07-20 Top-level assembly: block placement + wiring via a grid maze router
    tools/asm_top.py places every block/passive from PLACE, taps all
    terminals to met3 (met4 for cap C1/C2 plates), paints WIRES from
    tools/asm_wires.py, and runs fresh-process DRC + netgen LVS vs
    spice/golden/top.spice.
    Hand-routing 27 nets across ~110 terminals wasn't tractable by
    inspection, so tools/asm_route.py is a real grid-based (1um) maze
    router that enforces the same rules asm_top.py's own audit checks:
    horizontal runs (met3) forbidden over BLOCK+CAP bboxes, vertical runs
    (met4) forbidden over CAP bboxes only. It writes tools/asm_wires.py
    (generated -- do not hand-edit).
    Along the way, fixed several real bugs in asm_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
2026-07-21 Assembly v2: geometry-precise routing -- audit clean, topology LVS-correct
    Review of the v1 wiring found two real connectivity bugs (lad_p was
    missing rlp.R1 -- broken reference ladder -- and vcm was missing its
    cdec1.C1 decap plate) plus a far-reaching unit bug: .mag files carry a
    per-file coordinate scale (magscale), and every parser assumed the
    fine-grid value. cflt.mag is written without magscale (its geometry
    lands on the coarse grid), so cflt1/cflt2's cap children were misplaced
    by 6um in every parser and their C1/C2 straps painted into empty space.
    lay_lib.mag_units() now resolves the scale per file.
    The router's bbox-blanket obstacle model is replaced with real
    geometry: met3 obstac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
2026-07-21 sd_top DRC 0 + LVS clean: full modulator assembled and verified
    Closes the four DRC classes and two LVS items from the v2 checkpoint:
    - Block-port via stacks removed: every block port already carries a
    pre-built via1/via2/m3 riser landing (the earlier probe that said
    otherwise had a placement-offset bug); painting our own stack on
    top abutted the subcell contacts. Top wires land directly on the
    ports' own m3.
    - via3 bends closer than 0.7um merge into one elongated contact rect
    (two separate paints sat 0.06um apart against the 0.08 rule).
    - capm.11 closed at the root: the cap cells lift BOTH plates to met4
    (C1 via mimcapcontact, C2 via full-height via3 strips), so the C2
    strap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
2026-07-21 Extracted-top acceptance harness: PEX + shortened transient + SNDR gate
    tools/pex_top.py extracts sd_top with parasitic capacitances (same
    C-only flow as the OTA PEX; 132 devices + 593 caps / 2.9 pF of
    top-level wiring). sim/top_tb.py runs the full transistor-level
    modulator on that netlist for 512 bits, samples the UO0 bitstream at
    mid-period, and gates on fast-path SNDR >= 35 dB plus a sane ones
    density -- the campaign plan's sanity check for layout-introduced
    failure modes (broken loop, DAC polarity, dead reference). Makefile
    targets: asm / pextop / topaccept.
2026-07-21 Fix DAC feedback polarity: DFF Q/QB are swapped by construction
    First closed-loop PEX transient latched at the rail: every support
    block measured healthy (vcm 0.896, refs 0.445/1.389, ladder, bias,
    both clock phases), the comparator decided correctly, but dff.Q sat
    frozen at its power-up state. Root cause: dff_subckt's output chain
    is D -> mi -> inv -> mb -> si -> inv -> "QB" -> inv -> "Q", so the
    node labeled QB carries D's polarity and Q its complement -- the DFF
    inverts. Every derived artifact (golden, schematic, layout) inherited
    the swap self-consistently, so block LVS/equivalence never saw it,
    and the block testbench checked timing, not sense. With q33 = NOT
    decision the DAC feedback i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
2026-07-21 TT frame integration: sd_top in the 2x2 template, DRC 0, GDS/LEF exported
    The assembly now targets frame coordinates end-to-end: sd_top's die
    matches the tt_analog_2x2_3v3 template (319.24 x 225.76) and the five
    signal labels route to the def's exact pin positions (ua[0]/ua[1]
    bottom edge, uo_out[0]/uo_out[1]/clk top edge), so `def read` pin
    geometry and the design's met4 legs connect by overlap. build_frame.tcl
    v1: place sd_top at origin, draw three full-height met4 power stripes
    in lanes verified met4-free against the assembled design (VDPWR x221,
    VGND x256, VAPWR x310), tie each to its net with a met3 spur + via3
    onto an existing run. Frame DRC: 0. GDS + LEF exported. info.yaml:
    tiles 2x2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
2026-07-21 Frame fix: power port labels span the full stripe (precheck 10um edge rule)
    Precheck requires each power port's LEF geometry to reach within 10um
    of both tile edges; the labels were on a 4um mid-stripe patch.
2026-07-25 Report sub-pages per block + combined full-chip 3D viewer
    tools/block_report.py generalizes the geometry flattener to any cell
    (per-file magscale aware, stack extended with met4/via3, MiM plates,
    thin-oxide diffs, and the high-poly resistor body) and exports every
    block schematic to SVG. gen_docs.py builds public/blocks/<b>.html for
    each of the seven blocks -- testbench verdict chip, measured-results
    table, generated schematic, and the block's own 3D view -- and the
    main-page viewer now shows the COMPLETE modulator (sd_top, 64k rects
    through the full stack) instead of the OTA alone, with links to the
    sub-pages. The viewer JS is parametrized by geometry path. CI pages
    job runs block_report be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
2026-07-25 Docs: pins-and-TT-boundary section -- why IO edge asymmetry doesn't threaten the loop
    Answers a community question about TinyTapeout's unequal rise/fall
    propagation delays (a real hazard for sigma-delta DACs): the feedback
    DAC is internal and RZ, the clock path's asymmetry is a static duty
    shift (benign gain class, level shifter gated at 3%), and the
    bitstream is synchronously captured symbols. Also notes the as-built
    2x2 footprint against the original 1x2 estimate, and the exact pin
    table (2 analog pins; clock and data are digital).
2026-07-25 Input range 0-3.3 V + datasheet chapter in the site
    Range change (two resistors, loop untouched): RIN 40k -> 132k maps
    +-1.65 V about VIN_MID = 1.65 V (VAPWR/2, ratiometric) onto the same
    +-12.5 uA full scale, and a new ROFF = 158.4k from the sum node to
    VGND nulls the standing offset current. Both new resistors use the
    0.35 um high-poly bin (4x ohms/um) so they fit the old rin slot; the
    thin bin's end-m1 can't enclose the tap via alone, so R1/R2 taps now
    paint their own m1 pad. Verified end to end: tier-1 fast 37.5-38.5 /
    precision 55.8-60.5 dB over three tone placements (inside documented
    pattern-noise scatter; the network is linear and cannot alter the
    ideal-limit pattern noise), sd_top D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
    [tier1_sdm.sch]
2026-07-25 Close open item 7: 132k resistive input vs ADS131A04-class ~130k sources
2026-07-25 Nightly CI tier (assembly regression + corners) + top diagnostics
    CI: push pipelines keep only the jobs that feed the manual; a new
    scheduled nightly runs assembly-verify (full asm_route/asm_top/make
    tt regression, grep-gated) and top-corners (extracted acceptance at
    ss/ff). Schedule created on GitLab (03:00 America/Denver).
    top_tb: --corner/--tag plus two force-source diagnostics
    (--idealclk33, --idealrefs) for the decision-path-noise chase; first
    results show the 512-bit window scatter (+-3 dB) swamps the effect,
    so a 2048-bit A/B batch is running. Decap fill investigated and
    rejected: largest fitting standard MiM is ~0.25 pF (DESIGN.md).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
2026-07-25 Decision-path gap decomposed; clk33 edge fixed (+1.7 dB extracted)
    Same-window netlist ladder (2048 bits): tier-1 36.4 / golden 34.2 /
    extracted 32.3 dB -- so ~2.2 dB of the "extracted gap" is
    block-intrinsic and only ~1.9 dB was layout. A/B force-source runs
    excluded reference droop and coupling caps and pinned the clk33
    rising edge (545 ps at the comparator, P-limited). Fix: lvl output
    PMOS 2x (W_BP=20, duty gate 3->3.5% with tier-1 knee justification),
    buffers mid-row so the port risers clear the vcm met4 column.
    Measured edge 317 ps; extracted now 34.0 dB, equal to the
    zero-parasitic golden within 0.2 dB.
    Acceptance re-instrumented: 512-bit windows scatter +-3 dB (the old
    gate passed on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
2026-07-25 gen_sch lvl table: buffer PMOS uses W_BP (CI blockcheck catch)
    The 749fc3a resize updated the golden source but not the generated
    schematic's device table; support-blocks CI failed on the 2-vs-4
    finger mismatch. Regenerated schematic committed.
    [lvl.sch]
2026-07-25 assembly-verify: generate the golden top netlist in-job
    First scheduled run failed on the missing spice/golden/top.spice
    (gitignored build product; the dev tree always has it).
2026-07-25 Per-corner acceptance gates (--gate); ss first-characterized at 29.9 dB
    Nightly top-corners caught it: the tt-calibrated 33 dB gate fails at
    ss (29.9 measured, loop healthy). Corner gates now sit 1 dB under
    first-characterization values.
2026-07-25 Loop rephase: comparator senses at the modeled instant; extracted fast SNDR 34.0 -> 38.3-40.7 dB, above the tier-1 band
    The remaining "block-intrinsic" gap was pure excess loop delay: a
    StrongARM samples its input when its tail activates (its clock's
    FALLING edge), so clocked on clk33 the comparator sensed the
    integrator half a cycle earlier than tier-0/1 model. A golden-netlist
    A/B ladder (ideal switches / ideal comparator / kickback caps /
    isolated real comparator / fall-sampled ideal comparator) isolated
    the mechanism: the fall-sampled ideal reproduces the real
    comparator's loss exactly.
    Fix, zero new devices: comparator clocks on clkb33 (senses at the
    clk33 rise) and its SR latch drives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
2026-07-25 assembly-verify: build the full golden dependency chain in-job
    Second scheduled run got past the top golden and died on the OTA
    xschem netlist (also a build product). Run make xcheck + gen_golden
    before gen_top_golden.
2026-07-26 Three new analog pins (VOFF + vcm/vrefp monitors) and the silicon test plan
    ua[2] = VOFF: the 158.4k offset leg's bottom node, formerly
    hardwired to VGND -- grounded it is stock (1.65 V mid-scale); driven
    DC it slides the input window. Verified in extracted sim: VOFF=0.9 V
    moves the null to 0.9 V (ones density 0.732 measured vs 0.727
    predicted). ua[3]/ua[4] = vcm/vrefp monitors through new 100k
    thin-poly isolation cells (riso, 12x6.7 um) in the south margin
    strip over their pins. Differential input cannot be retrofitted
    passively -- that is the v2 fully-differential pass.
    Placement lesson recorded: label legs must descend THROUGH the label
    box (the first maze route arrived from below y=0 an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
2026-07-26 Test plan: AD5541A referenced to the VAPWR rail (ratiometric bench)
2026-07-26 Fabric RTL: suite green (5/5) — sine + AXI-poll tests, CI deps
    First run of the drafted sdm_rx/cocotb pair: RTL needed no changes;
    the TB needed sign-interpretation on DATA register reads and the
    cocotb 2.0 renames (unit=, COCOTB_TOPLEVEL/COCOTB_TEST_MODULES).
    New tests: test_sine (software MOD2 modulator, 0.6 FS sine at full
    bit rate, both paths checked bit-exact) and test_pex_axi_poll (the
    SoC usage pattern — every fast sample read live over AXI4-Lite,
    polled STATUS/W1C, plus CSV/PNG of the bus-read waveform).
    cloud-init grows iverilog/verilator/yosys and pinned cocotb deps
    for the upcoming rtl-verify job.
2026-07-26 CI: rtl-verify job (gated on rtl/ paths) with wave artifacts
    test_sine now records aclk-rate bit_i/data_fast/data_prec and renders
    sim_build/sine_waves.png -- the gtkwave view as a CI artifact,
    alongside the raw FST and the AXI-polled sample plot. The job runs
    the cocotb suite plus verilator lint (advisory, -Wno-fatal, until the
    warning set is cleaned) and a yosys parse smoke; rules:changes keeps
    it off pushes that don't touch rtl/.
2026-07-26 sim: np.trapz -> np.trapezoid (removed in numpy 2.0)
    Surfaced by the CI venv switch: the runner now pins numpy 2.4.2
    (same as the dev venv) instead of noble's system 1.26, and trapz was
    removed in 2.0. comparator/support-blocks failed on it; comp_tb
    --quick verified locally on 2.4.2.
2026-07-26 Clock-jitter susceptibility measured (tier 0): knees 24/169 ps, RZ 2x cost confirmed
    Closes open item 2's sub-item by measuring the curve instead of waiting
    for a PolarFire jitter number: per-edge Gaussian jitter on the RZ pulse
    (width modulation = unshaped input-band error) vs NRZ (transitions
    only). Jitter-only floor at 10 ps RMS: 73.5 dB precision / 63.5 dB
    fast; FPGA-class clocks sit >=10x under the precision knee. Gate
    extrapolates from the 1000 ps point at 20 dB/decade -- direct
    baseline subtraction false-fails on pattern-noise scatter.
2026-07-26 OTA 1/f noise bench (item 8): flicker-dominated band, budget holds; CI + datasheet wiring
    Transient CI simulates zero device noise, so flicker was invisible to
    the whole suite; sim/noise_tb.py (ngspice .noise on the ota_tb netlist,
    unity-buffer config) is the only 1/f coverage. Measured: 1/f corner
    631 kHz -- above the entire 100 kHz precision band -- but 126 uV rms
    input-referred (OTA 118 + resistors 43) vs the 351 uV quantization
    floor = ~0.5 dB; no chopping in v1. Wires both new benches into make
    (jitter/noise), CI (smoke snr job; --pex in layout-verify), and two
    datasheet rows (input-referred noise, jitter knees).
2026-07-26 Analog pins 5 -> 2 (VIN + INT): VOFF and vcm/vrefp monitors removed on cost
    100 EUR/analog pin after the first two (380 -> 80 EUR total). The
    monitors were DC-only through the 100k riso pole, and both DC values
    are inferable from the transfer function (mid-scale null -> vcm, full
    scale -> vrefp-vcm span); dead-chip debug falls to INT. The VOFF
    window-slide experiment moves to the v2/commercial part. Clean revert
    of 0ac7ff8's generators (roff.R2 back to VGND, riso cells deleted,
    sd_top 8 ports); test plan Phase 1 reworked to inference rows.
    Re-verified from source: sd_top DRC 0 / LVS match, extracted
    acceptance 40.2 dB (band 38.3-40.7 unchanged), frame DRC 0, GDS/LEF
    exported, info.yaml anal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
2026-07-27 Dead-board audit: 22 floating digital outputs tied to VGND; frame connectivity + cold start proven
    TT analog spec requires unused uo_out/uio_out/uio_oe tied to GND;
    precheck only checks pin geometry, so the 22 floating stubs passed
    green. On silicon they feed TT-mux tristate-buffer inputs (crowbar
    current; undefined uio_oe can drive board pins when selected). Fix:
    met4 bar gangs the contiguous stub block, dropping onto sd_top's
    VGND riser at x=74; frame DRC 0, extraction proves 22/22 tied with
    all live pins intact and mutually isolated.
    Also new: frame-level connectivity check (union-find over .ext
    merge+equiv), and top_tb --ramp cold-start regression (both supply
    orders, supplies PWL from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
2026-07-27 CI: frame-verify job -- the TT requirements precheck doesn't check
    tools/frame_check.py codifies the dead-board audit as a regression:
    magic extraction of the framed cell + union-find over .ext merge/equiv
    records. Gates: every info.yaml-described pin reaches its sd_top port;
    all undescribed uo_out/uio_out/uio_oe tied to VGND (the TT analog-spec
    rule the 07-26 audit caught violated); live pins pairwise isolated and
    ungrounded; supplies enter the design; unpaid ua pins touch nothing;
    analog_pins matches the pinout; no metal5 in any layout. Runs in a new
    push-gated frame-verify job (make tt + make framecheck), so the frame
    rebuild is exercised on every push too.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
2026-07-27 Submission integrity: deterministic GDS + antenna gate (both sky130A precheck gaps)
    magic 8.3.676 ignores `gds datestamp` on write; tools/gds_datenorm.py
    pins the 61 BGNLIB/BGNSTR date fields post-export -- identical
    geometry now yields byte-identical GDS, enabling frame-verify's new
    staleness gate (committed gds/lef must match a fresh rebuild). TT
    precheck's antenna deck is gf180mcuD-only, so sky130A ships unchecked:
    make antenna (magic antennacheck, sd_top CLEAN) now gates nightly.
2026-07-27 Nightly rail/temperature corners; test plan ESD + clock-jitter notes; RTL vector refresh
    top_tb grows --vapwr (ratiometric stimulus, like the bench) and
    --temp: measured 36.2 / 37.9 dB at VAPWR 3.0 / 3.6 and 34.7 / 38.5 dB
    at 0 / 85 C (vs 40.2 nominal); all healthy -- the cold run's 3.33 V
    integrator max was a 15-cycle startup episode inside the settle
    window, so the reported swing is now post-settle. Four nightly runs
    with gates ~1 dB under measured. Test plan: ESD handling procedure;
    clock-source jitter expectations (RP2040 first light can sit above
    the 24 ps precision knee -- bad precision SNDR there is predicted).
    pex_bits.txt regenerated from the 2-pin chip's 40.2 dB acceptance
    run; coc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
2026-07-28 top_tb: deterministic deck replaces the CI retry; gates re-baselined
    No retries in CI: the flake's causes are fixed structurally instead.
    num_threads=1 (OpenMP rounding order was the machine-dependence; 26%
    cost), abstol 1e-10 + itl4=200 for every run (1e-12 over-tight vs
    85 C leakage), and a bench-realistic 50-ohm source resistor (the
    failing equation was vin#branch on the ideal source). All nine
    nightly scenarios re-baselined bit-deterministically: nominal 39.5 /
    ss 34.5 / ff 38.7 / v3.0 37.5 / v3.6 34.8 / 0C 34.7 / 85C 36.7 dB,
    cold-starts ALIVE; gates at measured - 2 dB. A gate trip now means
    the design changed, never the machine.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
2026-07-29 Post-silicon survey of tt06-09 analog projects applied: test plan + bench-capture SNDR path
    Surveyed all 83 analog projects from the four shuttles with delivered
    silicon (52 had post-submission commits). Applied: chip-ROM board
    self-test as test 0.0 (htfab bring-up pattern); demo-board passives
    risk (a TT08 ring-osc measured low purely from a populated pull-down;
    its sibling died of a missing via -- the class our connectivity gates
    catch); battery-supply + CI-correlation notes for the precision-noise
    rows (devstdin's measured 1/f came in below sky130 sim); and
    sim/snr.py --bits so bench captures are judged by the byte-identical
    estimator as CI (wulffern tt06-sar pattern) -- verified to repro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
2026-07-29 Test plan: bench targets a custom PolarFire Icicle carrier, demo board optional
    First light can run on either; the chip-ROM self-test (0.0) is
    demo-board-specific, with the carrier equivalent being mux-select
    bring-up against the factory-test project. algofoogle's tt06
    interposer (KiCad + Gerbers in-repo) noted as the carrier reference.
2026-07-29 Test plan: demo board hosts the chip; the custom interface adapts its headers to the Icicle
    Correction of the previous commit's framing: the TT demo board stays
    (power, mux select, chip-ROM self-test), and the to-be-designed piece
    is the header adapter to the PolarFire SoC for clock, Q/QB capture,
    and analog access.
2026-07-29 Bench host generalized to "PolarFire SoC bench board"
2026-07-29 Test plan: input-cap footprints on the adapter + read timing against ss (tt06 SAR silicon data)
2026-08-01 Clip bottom-edge label legs at y=0: precheck boundary rewrite (tt-support-tools d869909e) rejects the old 0.3um met4 endcap overhang
    The UA0/UA1 wire legs ended on the die edge at y=0 and asm_top's
    painter extends a MW/2 endcap past the endpoint, leaving two met4
    rects at y=-0.3um. The old upstream boundary check never recursed
    into cell references so it silently passed; the 2026-07-28 rewrite
    flattens and rejects any shape outside (0,0)-(319.24,225.76).
    asm_route now stops label legs at MW/2 and asm_top's paint() hard-
    fails on any box leaving the die area, so this class of bug breaks
    the local build instead of the shuttle precheck.
2026-08-01 Refresh committed block .ext files from the current magic build
    Rebuild side effect, no geometry change: the committed extraction
    products came from an older magic revision; the local 8.3.676 names
    and orders coupling-cap nodes differently (~2k lines per block).
    mag/*.spice and LVS results are unchanged.
2026-08-01 Canonical PEX netlist: kill the ext2spice ordering nondeterminism behind the nightly convergence flake
    Root cause of the 2026-07-31 top-corners abort: ext2spice emits the
    parasitic cap lines in per-process hash order (only 69 of 684 pairs
    kept their position across two back-to-back runs) with ~0.01 aF
    last-digit jitter, so every nightly simulated a differently-ordered
    deck -- different ngspice matrix ordering, different roundoff,
    different trajectory. Usually converged; that night the vapwr-3.0
    corner hit a timestep collapse on a 5V nfet body node.
    pex_top.py now sorts caps by node pair, renumbers, and rounds to
    1 aF (all suffixes normalized to fF -- the stats line previously
    missed the p-s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
